Efllux/fw2usb/hardware/README.md

# hardware

KiCad designs, licensed CERN-OHL-S v2 (strongly reciprocal) (see `LICENSE` in this folder).

- `phy-breakout/`: PHY breakout for FPGA dev boards (TSB41BA3F-EP, one FW400 port). Routed and
  checked, not yet built. See its README.
- Planned: the final dongle. See ROADMAP M1 and M5.
