Efllux/fw2usb/host/README.md

# host

Rust user-space tools for the computer side (libusb, no kernel driver): `fw2usb-cli` for bus
info, config ROM dumps and WAV recording via the raw-link mode. Not started; see ROADMAP M3.
