Efllux/fw2usb/docs/devices/tascam.md

# TASCAM vendor protocol

Research, not fw2usb device support. Primary source snapshots are pinned below.

Stream: CIP-like PCM plus capture counter/status quadlets. Control: Vendor registers, separate async control/MIDI. Linux: `snd-firewire-tascam`.

## Start, clock and recovery

Select formats/rate, reserve resources; program TX channel, unknown register=2, RX channel, start=1, RX on=1, option=0x2000, multiplex PCM enable; add playback at peer speed and capture at S400; start event-count replay domain (16000 initial skips when needed), wait ready. Failure stops domain and finishes session.

Capture includes two non-PCM quadlets; MIDI/status is not a generic AM824 layout. Firmware can delay event multiplexing after rate change; received SYT ignored, packet cadence matters. Unknown register purposes must remain explicit.

Firmware upload: No routine Linux stream-start upload; boot/recovery unknown.

## Tier-1 profile requirements

Match ROM IDs and firmware revisions, include per-rate/per-optical-mode capture
and playback wire layouts, PCM slot map, MIDI/control placement, peak packet
size, bus-speed requirements, clock source/lock operations, packet cadence and
timestamp rules, resource acquisition, bounded startup waits, error teardown
and generation-reset recovery. Encode family-specific quirks above explicitly.
Do not expose unsupported rates or infer channel count from the product name.

## Model evidence

Counts below are capture/playback PCM, excluding MIDI; ? means **[verify]** from
capability queries or captures, not zero channels. Clock behavior, upload needs
and quirks inherit the family discussion; per-model exceptions need verification.
FFADO registration indicates a source match, not fw2usb or current FFADO validation.

| Vendor | Model | ROM vendor/model | PCM at <=48 / 88.2–96 / 176.4–192 kHz | Source |
|---|---|---|---|---|
| TASCAM | FW-1884 | see ROM match table | ? / ? / ? | [match](https://github.com/torvalds/linux/blob/7475ea8b58616b33c04afb976cf0fbaad9dd63fb/sound/firewire/tascam/tascam.c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) |
| TASCAM | FW-1082 | see ROM match table | ? / ? / ? | [match](https://github.com/torvalds/linux/blob/7475ea8b58616b33c04afb976cf0fbaad9dd63fb/sound/firewire/tascam/tascam.c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) |
| TASCAM | FW-1804 | see ROM match table | ? / ? / ? | [match](https://github.com/torvalds/linux/blob/7475ea8b58616b33c04afb976cf0fbaad9dd63fb/sound/firewire/tascam/tascam.c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) |

## Primary implementation references

- [sound/firewire/tascam/tascam-stream.c:1–551](https://github.com/torvalds/linux/blob/7475ea8b58616b33c04afb976cf0fbaad9dd63fb/sound/firewire/tascam/tascam-stream.c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)
- [sound/firewire/tascam/tascam.c:1–235](https://github.com/torvalds/linux/blob/7475ea8b58616b33c04afb976cf0fbaad9dd63fb/sound/firewire/tascam/tascam.c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)
- [sound/firewire/tascam/amdtp-tascam.c:1–252](https://github.com/torvalds/linux/blob/7475ea8b58616b33c04afb976cf0fbaad9dd63fb/sound/firewire/tascam/amdtp-tascam.c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)

### Sequence and layout audit anchors

- [tascam/tascam-stream.c:222–280](https://github.com/torvalds/linux/blob/7475ea8b58616b33c04afb976cf0fbaad9dd63fb/sound/firewire/tascam/tascam-stream.c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)
- [tascam/tascam-stream.c:435–510](https://github.com/torvalds/linux/blob/7475ea8b58616b33c04afb976cf0fbaad9dd63fb/sound/firewire/tascam/tascam-stream.c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)
- [tascam/tascam.c:14–43](https://github.com/torvalds/linux/blob/7475ea8b58616b33c04afb976cf0fbaad9dd63fb/sound/firewire/tascam/tascam.c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)

### Channel derivation

The model table tascam.c:14–43 gives FW1884 analog 8/8, FW1082 8/2,
FW1804 8/2. tascam-stream.c:306–324 adds eight slots for ADAT-equipped
models and two for S/PDIF-equipped models: FW1884 18/18, FW1082 10/4,
FW1804 18/12 wire PCM slots. Capture adds two counter/status quadlets.
These fixed wire slots must not be confused with active optical channel count
at each rate; validate digital-mode operation at 88.2/96 kHz [verify].
