Efllux/fw2usb/hardware/soft-phy-afe/spice/eye.png

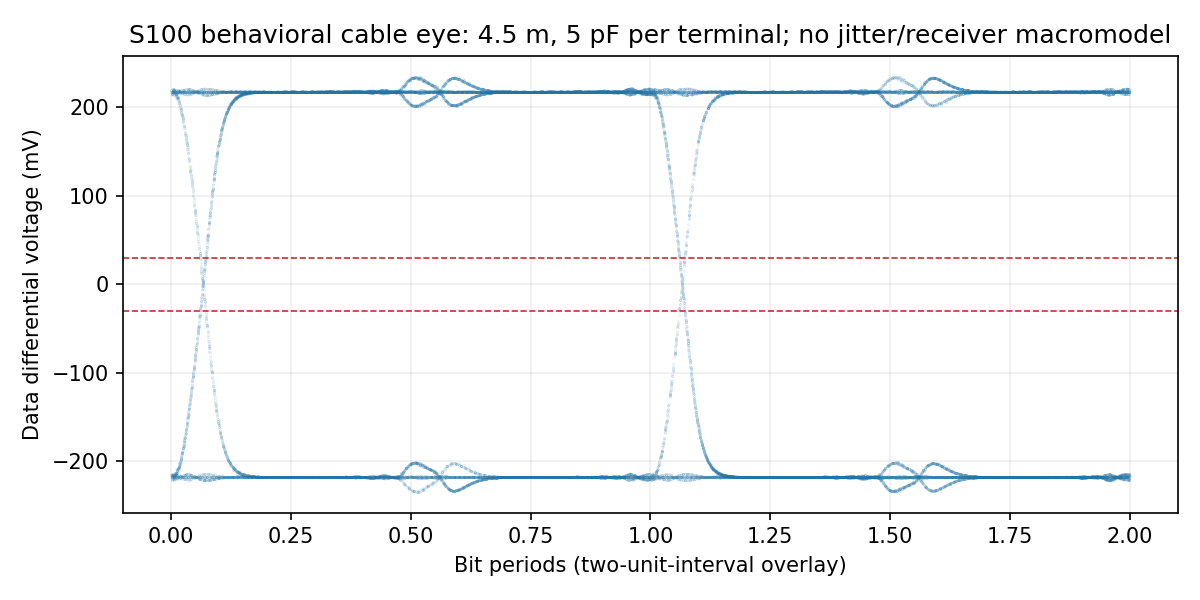
hardware/soft-phy-afe/spice/eye.png
