Efllux/fw2usb/docs/devices/models.csv

vendor | model | family | ids | source | stream_format | control_protocol | firmware_upload | pcm_counts_per_rate | clock_behavior | quirks | linux_driver | ffado_evidence
Mackie | Onyx Firewire | bebob | 0x00000f/0x00010065 | https://github.com/adiknoth/ffado/blob/4b7f9e86e59ce95f5c60d5eb3070bc75a3dfdd3f/libffado/configuration | CIP AM824 | AV/C/FCP extended stream/plug commands, CMP, vendor mixer | Some M-Audio bootloader identities require host firmware loading; others unknown until firmware identity checked. | [verify]; see family page | see family page; model-specific lock behavior [verify] | see family page; firmware revision [verify] | snd-bebob | configuration registration
Mackie | Onyx Firewire | bebob | 0x00000f/0x00010067 | https://github.com/adiknoth/ffado/blob/4b7f9e86e59ce95f5c60d5eb3070bc75a3dfdd3f/libffado/configuration | CIP AM824 | AV/C/FCP extended stream/plug commands, CMP, vendor mixer | Some M-Audio bootloader identities require host firmware loading; others unknown until firmware identity checked. | [verify]; see family page | see family page; model-specific lock behavior [verify] | see family page; firmware revision [verify] | snd-bebob | configuration registration
Tascam | IFFWDM | bebob | 0x0022E/0x10067 | https://github.com/adiknoth/ffado/blob/4b7f9e86e59ce95f5c60d5eb3070bc75a3dfdd3f/libffado/configuration | CIP AM824 | AV/C/FCP extended stream/plug commands, CMP, vendor mixer | Some M-Audio bootloader identities require host firmware loading; others unknown until firmware identity checked. | [verify]; see family page | see family page; model-specific lock behavior [verify] | see family page; firmware revision [verify] | snd-bebob | configuration registration
Loud Technologies Inc. | Onyx 1640i (DICE) | dice | 0x000ff2/0x000006 | https://github.com/adiknoth/ffado/blob/4b7f9e86e59ce95f5c60d5eb3070bc75a3dfdd3f/libffado/configuration | CIP AM824, multiple streams, high-rate dual-wire variants | DICE register sections, owner/notification transactions, vendor extensions | No routine Linux stream-start upload; revision-specific boot/recovery unknown. | [verify]; see family page | see family page; model-specific lock behavior [verify] | see family page; firmware revision [verify] | snd-dice | configuration registration
Loud Technologies Inc. | Onyx Blackbird | dice | 0x000ff2/0x000007 | https://github.com/adiknoth/ffado/blob/4b7f9e86e59ce95f5c60d5eb3070bc75a3dfdd3f/libffado/configuration | CIP AM824, multiple streams, high-rate dual-wire variants | DICE register sections, owner/notification transactions, vendor extensions | No routine Linux stream-start upload; revision-specific boot/recovery unknown. | [verify]; see family page | see family page; model-specific lock behavior [verify] | see family page; firmware revision [verify] | snd-dice | configuration registration
Loud Technologies Inc. | Onyx 1640i (Oxford) | oxfw | 0x000ff2/0x001640 | https://github.com/adiknoth/ffado/blob/4b7f9e86e59ce95f5c60d5eb3070bc75a3dfdd3f/libffado/configuration | CIP AM824, nonblocking/jumbo quirks | AV/C/FCP stream format + CMP; model mixer commands | No routine Linux stream-start upload; other firmware states unknown. | [verify]; see family page | see family page; model-specific lock behavior [verify] | see family page; firmware revision [verify] | snd-oxfw | configuration registration
Loud Technologies Inc. | Onyx-i | oxfw | 0x000ff2/0x081216 | https://github.com/adiknoth/ffado/blob/4b7f9e86e59ce95f5c60d5eb3070bc75a3dfdd3f/libffado/configuration | CIP AM824, nonblocking/jumbo quirks | AV/C/FCP stream format + CMP; model mixer commands | No routine Linux stream-start upload; other firmware states unknown. | [verify]; see family page | see family page; model-specific lock behavior [verify] | see family page; firmware revision [verify] | snd-oxfw | configuration registration
Behringer | X32 | bebob | 0x001564/0x00000006 | https://github.com/adiknoth/ffado/blob/4b7f9e86e59ce95f5c60d5eb3070bc75a3dfdd3f/libffado/configuration | CIP AM824 | AV/C/FCP extended stream/plug commands, CMP, vendor mixer | Some M-Audio bootloader identities require host firmware loading; others unknown until firmware identity checked. | [verify]; see family page | see family page; model-specific lock behavior [verify] | see family page; firmware revision [verify] | snd-bebob | configuration registration
Behringer | UFX-1604 mixer | bebob | 0x001564/0x00001604 | https://github.com/adiknoth/ffado/blob/4b7f9e86e59ce95f5c60d5eb3070bc75a3dfdd3f/libffado/configuration | CIP AM824 | AV/C/FCP extended stream/plug commands, CMP, vendor mixer | Some M-Audio bootloader identities require host firmware loading; others unknown until firmware identity checked. | [verify]; see family page | see family page; model-specific lock behavior [verify] | see family page; firmware revision [verify] | snd-bebob | configuration registration
Apogee Electronics | Rosetta 200 | bebob | 0x0003db/0x00010048 | https://github.com/adiknoth/ffado/blob/4b7f9e86e59ce95f5c60d5eb3070bc75a3dfdd3f/libffado/configuration | CIP AM824 | AV/C/FCP extended stream/plug commands, CMP, vendor mixer | Some M-Audio bootloader identities require host firmware loading; others unknown until firmware identity checked. | [verify]; see family page | see family page; model-specific lock behavior [verify] | see family page; firmware revision [verify] | snd-bebob | configuration registration
BridgeCo | RD Audio1 | bebob | 0x0007f5/0x00010048 | https://github.com/adiknoth/ffado/blob/4b7f9e86e59ce95f5c60d5eb3070bc75a3dfdd3f/libffado/configuration | CIP AM824 | AV/C/FCP extended stream/plug commands, CMP, vendor mixer | Some M-Audio bootloader identities require host firmware loading; others unknown until firmware identity checked. | [verify]; see family page | see family page; model-specific lock behavior [verify] | see family page; firmware revision [verify] | snd-bebob | configuration registration
BridgeCo | Audio 5 | bebob | 0x0007f5/0x00010049 | https://github.com/adiknoth/ffado/blob/4b7f9e86e59ce95f5c60d5eb3070bc75a3dfdd3f/libffado/configuration | CIP AM824 | AV/C/FCP extended stream/plug commands, CMP, vendor mixer | Some M-Audio bootloader identities require host firmware loading; others unknown until firmware identity checked. | [verify]; see family page | see family page; model-specific lock behavior [verify] | see family page; firmware revision [verify] | snd-bebob | configuration registration
PreSonus | FIREBOX | bebob | 0x000a92/0x00010000 | https://github.com/adiknoth/ffado/blob/4b7f9e86e59ce95f5c60d5eb3070bc75a3dfdd3f/libffado/configuration | CIP AM824 | AV/C/FCP extended stream/plug commands, CMP, vendor mixer | Some M-Audio bootloader identities require host firmware loading; others unknown until firmware identity checked. | [verify]; see family page | see family page; model-specific lock behavior [verify] | see family page; firmware revision [verify] | snd-bebob | configuration registration
PreSonus | Inspire1394 | bebob | 0x000a92/0x00010001 | https://github.com/adiknoth/ffado/blob/4b7f9e86e59ce95f5c60d5eb3070bc75a3dfdd3f/libffado/configuration | CIP AM824 | AV/C/FCP extended stream/plug commands, CMP, vendor mixer | Some M-Audio bootloader identities require host firmware loading; others unknown until firmware identity checked. | [verify]; see family page | see family page; model-specific lock behavior [verify] | see family page; firmware revision [verify] | snd-bebob | configuration registration
PreSonus | FirePOD | bebob | 0x000a92/0x00010066 | https://github.com/adiknoth/ffado/blob/4b7f9e86e59ce95f5c60d5eb3070bc75a3dfdd3f/libffado/configuration | CIP AM824 | AV/C/FCP extended stream/plug commands, CMP, vendor mixer | Some M-Audio bootloader identities require host firmware loading; others unknown until firmware identity checked. | [verify]; see family page | see family page; model-specific lock behavior [verify] | see family page; firmware revision [verify] | snd-bebob | configuration registration
Presonus | Firestudio 26x26 | dice | 0x000a92/0x00000008 | https://github.com/adiknoth/ffado/blob/4b7f9e86e59ce95f5c60d5eb3070bc75a3dfdd3f/libffado/configuration | CIP AM824, multiple streams, high-rate dual-wire variants | DICE register sections, owner/notification transactions, vendor extensions | No routine Linux stream-start upload; revision-specific boot/recovery unknown. | [verify]; see family page | see family page; model-specific lock behavior [verify] | see family page; firmware revision [verify] | snd-dice | configuration registration
Presonus | Firestudio Project | dice | 0x000a92/0x0000000b | https://github.com/adiknoth/ffado/blob/4b7f9e86e59ce95f5c60d5eb3070bc75a3dfdd3f/libffado/configuration | CIP AM824, multiple streams, high-rate dual-wire variants | DICE register sections, owner/notification transactions, vendor extensions | No routine Linux stream-start upload; revision-specific boot/recovery unknown. | [verify]; see family page | see family page; model-specific lock behavior [verify] | see family page; firmware revision [verify] | snd-dice | configuration registration
Presonus | Firestudio Tube | dice | 0x000a92/0x0000000c | https://github.com/adiknoth/ffado/blob/4b7f9e86e59ce95f5c60d5eb3070bc75a3dfdd3f/libffado/configuration | CIP AM824, multiple streams, high-rate dual-wire variants | DICE register sections, owner/notification transactions, vendor extensions | No routine Linux stream-start upload; revision-specific boot/recovery unknown. | [verify]; see family page | see family page; model-specific lock behavior [verify] | see family page; firmware revision [verify] | snd-dice | configuration registration
PreSonus | Firestudio Mobile | dice | 0x000a92/0x00000011 | https://github.com/adiknoth/ffado/blob/4b7f9e86e59ce95f5c60d5eb3070bc75a3dfdd3f/libffado/configuration | CIP AM824, multiple streams, high-rate dual-wire variants | DICE register sections, owner/notification transactions, vendor extensions | No routine Linux stream-start upload; revision-specific boot/recovery unknown. | [verify]; see family page | see family page; model-specific lock behavior [verify] | see family page; firmware revision [verify] | snd-dice | configuration registration
PreSonus | STUDIOLIVE_2442 | dice | 0x00000A92/0x00000012 | https://github.com/adiknoth/ffado/blob/4b7f9e86e59ce95f5c60d5eb3070bc75a3dfdd3f/libffado/configuration | CIP AM824, multiple streams, high-rate dual-wire variants | DICE register sections, owner/notification transactions, vendor extensions | No routine Linux stream-start upload; revision-specific boot/recovery unknown. | [verify]; see family page | see family page; model-specific lock behavior [verify] | see family page; firmware revision [verify] | snd-dice | configuration registration
PreSonus | STUDIOLIVE_1602 | dice | 0x00000A92/0x00000013 | https://github.com/adiknoth/ffado/blob/4b7f9e86e59ce95f5c60d5eb3070bc75a3dfdd3f/libffado/configuration | CIP AM824, multiple streams, high-rate dual-wire variants | DICE register sections, owner/notification transactions, vendor extensions | No routine Linux stream-start upload; revision-specific boot/recovery unknown. | [verify]; see family page | see family page; model-specific lock behavior [verify] | see family page; firmware revision [verify] | snd-dice | configuration registration
PreSonus | STUDIOLIVE_3242_mk2 | dice | 0x00000a92/0x00000014 | https://github.com/adiknoth/ffado/blob/4b7f9e86e59ce95f5c60d5eb3070bc75a3dfdd3f/libffado/configuration | CIP AM824, multiple streams, high-rate dual-wire variants | DICE register sections, owner/notification transactions, vendor extensions | No routine Linux stream-start upload; revision-specific boot/recovery unknown. | [verify]; see family page | see family page; model-specific lock behavior [verify] | see family page; firmware revision [verify] | snd-dice | configuration registration
TerraTec Electronic GmbH | Phase 88 FW | bebob | 0x000aac/0x00000003 | https://github.com/adiknoth/ffado/blob/4b7f9e86e59ce95f5c60d5eb3070bc75a3dfdd3f/libffado/configuration | CIP AM824 | AV/C/FCP extended stream/plug commands, CMP, vendor mixer | Some M-Audio bootloader identities require host firmware loading; others unknown until firmware identity checked. | [verify]; see family page | see family page; model-specific lock behavior [verify] | see family page; firmware revision [verify] | snd-bebob | configuration registration
TerraTec Electronic GmbH | Phase X24 FW (model version 4) | bebob | 0x000aac/0x00000004 | https://github.com/adiknoth/ffado/blob/4b7f9e86e59ce95f5c60d5eb3070bc75a3dfdd3f/libffado/configuration | CIP AM824 | AV/C/FCP extended stream/plug commands, CMP, vendor mixer | Some M-Audio bootloader identities require host firmware loading; others unknown until firmware identity checked. | [verify]; see family page | see family page; model-specific lock behavior [verify] | see family page; firmware revision [verify] | snd-bebob | configuration registration
TerraTec Electronic GmbH | Phase X24 FW (model version 7) | bebob | 0x000aac/0x00000007 | https://github.com/adiknoth/ffado/blob/4b7f9e86e59ce95f5c60d5eb3070bc75a3dfdd3f/libffado/configuration | CIP AM824 | AV/C/FCP extended stream/plug commands, CMP, vendor mixer | Some M-Audio bootloader identities require host firmware loading; others unknown until firmware identity checked. | [verify]; see family page | see family page; model-specific lock behavior [verify] | see family page; firmware revision [verify] | snd-bebob | configuration registration
ESI | Quatafire 610 | bebob | 0x000f1b/0x00010064 | https://github.com/adiknoth/ffado/blob/4b7f9e86e59ce95f5c60d5eb3070bc75a3dfdd3f/libffado/configuration | CIP AM824 | AV/C/FCP extended stream/plug commands, CMP, vendor mixer | Some M-Audio bootloader identities require host firmware loading; others unknown until firmware identity checked. | [verify]; see family page | see family page; model-specific lock behavior [verify] | see family page; firmware revision [verify] | snd-bebob | configuration registration
Focusrite | Saffire Pro26IO | bebob | 0x00130e/0x00000003 | https://github.com/adiknoth/ffado/blob/4b7f9e86e59ce95f5c60d5eb3070bc75a3dfdd3f/libffado/configuration | CIP AM824 | AV/C/FCP extended stream/plug commands, CMP, vendor mixer | Some M-Audio bootloader identities require host firmware loading; others unknown until firmware identity checked. | [verify]; see family page | see family page; model-specific lock behavior [verify] | see family page; firmware revision [verify] | snd-bebob | configuration registration
Focusrite | Saffire Pro10IO | bebob | 0x00130e/0x00000006 | https://github.com/adiknoth/ffado/blob/4b7f9e86e59ce95f5c60d5eb3070bc75a3dfdd3f/libffado/configuration | CIP AM824 | AV/C/FCP extended stream/plug commands, CMP, vendor mixer | Some M-Audio bootloader identities require host firmware loading; others unknown until firmware identity checked. | [verify]; see family page | see family page; model-specific lock behavior [verify] | see family page; firmware revision [verify] | snd-bebob | configuration registration
Focusrite | Saffire (LE) | bebob | 0x00130e/0x00000000 | https://github.com/adiknoth/ffado/blob/4b7f9e86e59ce95f5c60d5eb3070bc75a3dfdd3f/libffado/configuration | CIP AM824 | AV/C/FCP extended stream/plug commands, CMP, vendor mixer | Some M-Audio bootloader identities require host firmware loading; others unknown until firmware identity checked. | [verify]; see family page | see family page; model-specific lock behavior [verify] | see family page; firmware revision [verify] | snd-bebob | configuration registration
EDIROL | FA-66 | bebob | 0x0040ab/0x00010049 | https://github.com/adiknoth/ffado/blob/4b7f9e86e59ce95f5c60d5eb3070bc75a3dfdd3f/libffado/configuration | CIP AM824 | AV/C/FCP extended stream/plug commands, CMP, vendor mixer | Some M-Audio bootloader identities require host firmware loading; others unknown until firmware identity checked. | [verify]; see family page | see family page; model-specific lock behavior [verify] | see family page; firmware revision [verify] | snd-bebob | configuration registration
EDIROL | FA-101 | bebob | 0x0040ab/0x00010048 | https://github.com/adiknoth/ffado/blob/4b7f9e86e59ce95f5c60d5eb3070bc75a3dfdd3f/libffado/configuration | CIP AM824 | AV/C/FCP extended stream/plug commands, CMP, vendor mixer | Some M-Audio bootloader identities require host firmware loading; others unknown until firmware identity checked. | [verify]; see family page | see family page; model-specific lock behavior [verify] | see family page; firmware revision [verify] | snd-bebob | configuration registration
M-Audio | Ozonic | bebob | 0x000d6c/0x0000000a | https://github.com/adiknoth/ffado/blob/4b7f9e86e59ce95f5c60d5eb3070bc75a3dfdd3f/libffado/configuration | CIP AM824 | AV/C/FCP extended stream/plug commands, CMP, vendor mixer | Some M-Audio bootloader identities require host firmware loading; others unknown until firmware identity checked. | [verify]; see family page | see family page; model-specific lock behavior [verify] | see family page; firmware revision [verify] | snd-bebob | configuration registration
M-Audio | FW Solo | bebob | 0x000d6c/0x00010062 | https://github.com/adiknoth/ffado/blob/4b7f9e86e59ce95f5c60d5eb3070bc75a3dfdd3f/libffado/configuration | CIP AM824 | AV/C/FCP extended stream/plug commands, CMP, vendor mixer | Some M-Audio bootloader identities require host firmware loading; others unknown until firmware identity checked. | [verify]; see family page | see family page; model-specific lock behavior [verify] | see family page; firmware revision [verify] | snd-bebob | configuration registration
M-Audio | NRV10 | bebob | 0x000d6c/0x00010081 | https://github.com/adiknoth/ffado/blob/4b7f9e86e59ce95f5c60d5eb3070bc75a3dfdd3f/libffado/configuration | CIP AM824 | AV/C/FCP extended stream/plug commands, CMP, vendor mixer | Some M-Audio bootloader identities require host firmware loading; others unknown until firmware identity checked. | [verify]; see family page | see family page; model-specific lock behavior [verify] | see family page; firmware revision [verify] | snd-bebob | configuration registration
M-Audio | FW Audiophile | bebob | 0x000d6c/0x00010060 | https://github.com/adiknoth/ffado/blob/4b7f9e86e59ce95f5c60d5eb3070bc75a3dfdd3f/libffado/configuration | CIP AM824 | AV/C/FCP extended stream/plug commands, CMP, vendor mixer | Some M-Audio bootloader identities require host firmware loading; others unknown until firmware identity checked. | [verify]; see family page | see family page; model-specific lock behavior [verify] | see family page; firmware revision [verify] | snd-bebob | configuration registration
M-Audio | FW 410 | bebob | 0x000d6c/0x00010046 | https://github.com/adiknoth/ffado/blob/4b7f9e86e59ce95f5c60d5eb3070bc75a3dfdd3f/libffado/configuration | CIP AM824 | AV/C/FCP extended stream/plug commands, CMP, vendor mixer | Some M-Audio bootloader identities require host firmware loading; others unknown until firmware identity checked. | [verify]; see family page | see family page; model-specific lock behavior [verify] | see family page; firmware revision [verify] | snd-bebob | configuration registration
M-Audio | FW 1814 | bebob | 0x000d6c/0x00010071 | https://github.com/adiknoth/ffado/blob/4b7f9e86e59ce95f5c60d5eb3070bc75a3dfdd3f/libffado/configuration | CIP AM824 | AV/C/FCP extended stream/plug commands, CMP, vendor mixer | Some M-Audio bootloader identities require host firmware loading; others unknown until firmware identity checked. | [verify]; see family page | see family page; model-specific lock behavior [verify] | see family page; firmware revision [verify] | snd-bebob | configuration registration
M-Audio | ProjectMix I/O | bebob | 0x000d6c/0x00010091 | https://github.com/adiknoth/ffado/blob/4b7f9e86e59ce95f5c60d5eb3070bc75a3dfdd3f/libffado/configuration | CIP AM824 | AV/C/FCP extended stream/plug commands, CMP, vendor mixer | Some M-Audio bootloader identities require host firmware loading; others unknown until firmware identity checked. | [verify]; see family page | see family page; model-specific lock behavior [verify] | see family page; firmware revision [verify] | snd-bebob | configuration registration
M-Audio | ProFire Lightbridge | bebob | 0x000d6c/0x000100A1 | https://github.com/adiknoth/ffado/blob/4b7f9e86e59ce95f5c60d5eb3070bc75a3dfdd3f/libffado/configuration | CIP AM824 | AV/C/FCP extended stream/plug commands, CMP, vendor mixer | Some M-Audio bootloader identities require host firmware loading; others unknown until firmware identity checked. | [verify]; see family page | see family page; model-specific lock behavior [verify] | see family page; firmware revision [verify] | snd-bebob | configuration registration
M-Audio | ProFire 2626 | dice | 0x000d6c/0x00000010 | https://github.com/adiknoth/ffado/blob/4b7f9e86e59ce95f5c60d5eb3070bc75a3dfdd3f/libffado/configuration | CIP AM824, multiple streams, high-rate dual-wire variants | DICE register sections, owner/notification transactions, vendor extensions | No routine Linux stream-start upload; revision-specific boot/recovery unknown. | [verify]; see family page | see family page; model-specific lock behavior [verify] | see family page; firmware revision [verify] | snd-dice | configuration registration
M-Audio | ProFire 610 | dice | 0x000d6c/0x00000011 | https://github.com/adiknoth/ffado/blob/4b7f9e86e59ce95f5c60d5eb3070bc75a3dfdd3f/libffado/configuration | CIP AM824, multiple streams, high-rate dual-wire variants | DICE register sections, owner/notification transactions, vendor extensions | No routine Linux stream-start upload; revision-specific boot/recovery unknown. | [verify]; see family page | see family page; model-specific lock behavior [verify] | see family page; firmware revision [verify] | snd-dice | configuration registration
Acoustic Reality | eAR Master One | bebob | 0x000aac/0x00000002 | https://github.com/adiknoth/ffado/blob/4b7f9e86e59ce95f5c60d5eb3070bc75a3dfdd3f/libffado/configuration | CIP AM824 | AV/C/FCP extended stream/plug commands, CMP, vendor mixer | Some M-Audio bootloader identities require host firmware loading; others unknown until firmware identity checked. | [verify]; see family page | see family page; model-specific lock behavior [verify] | see family page; firmware revision [verify] | snd-bebob | configuration registration
CME | Matrix K FW | bebob | 0x0000000A/0x00030000 | https://github.com/adiknoth/ffado/blob/4b7f9e86e59ce95f5c60d5eb3070bc75a3dfdd3f/libffado/configuration | CIP AM824 | AV/C/FCP extended stream/plug commands, CMP, vendor mixer | Some M-Audio bootloader identities require host firmware loading; others unknown until firmware identity checked. | [verify]; see family page | see family page; model-specific lock behavior [verify] | see family page; firmware revision [verify] | snd-bebob | configuration registration
Echo | AudioFire2 | fireworks | 0x1486/0xAF2 | https://github.com/adiknoth/ffado/blob/4b7f9e86e59ce95f5c60d5eb3070bc75a3dfdd3f/libffado/configuration | CIP AM824 with EFW DBC/SYT quirks | EFW command/response over async transactions, CMP | Flash firmware state/version queried; no routine stream-start upload. | [verify]; see family page | see family page; model-specific lock behavior [verify] | see family page; firmware revision [verify] | snd-fireworks | configuration registration
Echo | AudioFire4 | fireworks | 0x1486/0xAF4 | https://github.com/adiknoth/ffado/blob/4b7f9e86e59ce95f5c60d5eb3070bc75a3dfdd3f/libffado/configuration | CIP AM824 with EFW DBC/SYT quirks | EFW command/response over async transactions, CMP | Flash firmware state/version queried; no routine stream-start upload. | [verify]; see family page | see family page; model-specific lock behavior [verify] | see family page; firmware revision [verify] | snd-fireworks | configuration registration
Echo | AudioFire8 | fireworks | 0x1486/0xAF8 | https://github.com/adiknoth/ffado/blob/4b7f9e86e59ce95f5c60d5eb3070bc75a3dfdd3f/libffado/configuration | CIP AM824 with EFW DBC/SYT quirks | EFW command/response over async transactions, CMP | Flash firmware state/version queried; no routine stream-start upload. | [verify]; see family page | see family page; model-specific lock behavior [verify] | see family page; firmware revision [verify] | snd-fireworks | configuration registration
Echo | AudioFire8a | fireworks | 0x1486/0xAF9 | https://github.com/adiknoth/ffado/blob/4b7f9e86e59ce95f5c60d5eb3070bc75a3dfdd3f/libffado/configuration | CIP AM824 with EFW DBC/SYT quirks | EFW command/response over async transactions, CMP | Flash firmware state/version queried; no routine stream-start upload. | [verify]; see family page | see family page; model-specific lock behavior [verify] | see family page; firmware revision [verify] | snd-fireworks | configuration registration
Echo | AudioFire12 | fireworks | 0x1486/0xAF12 | https://github.com/adiknoth/ffado/blob/4b7f9e86e59ce95f5c60d5eb3070bc75a3dfdd3f/libffado/configuration | CIP AM824 with EFW DBC/SYT quirks | EFW command/response over async transactions, CMP | Flash firmware state/version queried; no routine stream-start upload. | [verify]; see family page | see family page; model-specific lock behavior [verify] | see family page; firmware revision [verify] | snd-fireworks | configuration registration
Echo | AudioFire12HD | fireworks | 0x1486/0xAF12D | https://github.com/adiknoth/ffado/blob/4b7f9e86e59ce95f5c60d5eb3070bc75a3dfdd3f/libffado/configuration | CIP AM824 with EFW DBC/SYT quirks | EFW command/response over async transactions, CMP | Flash firmware state/version queried; no routine stream-start upload. | [verify]; see family page | see family page; model-specific lock behavior [verify] | see family page; firmware revision [verify] | snd-fireworks | configuration registration
Echo | Fireworks 8 | fireworks | 0x1486/0xF8 | https://github.com/adiknoth/ffado/blob/4b7f9e86e59ce95f5c60d5eb3070bc75a3dfdd3f/libffado/configuration | CIP AM824 with EFW DBC/SYT quirks | EFW command/response over async transactions, CMP | Flash firmware state/version queried; no routine stream-start upload. | [verify]; see family page | see family page; model-specific lock behavior [verify] | see family page; firmware revision [verify] | snd-fireworks | configuration registration
Echo | FW HDMI | fireworks | 0x1486/0xAFD1 | https://github.com/adiknoth/ffado/blob/4b7f9e86e59ce95f5c60d5eb3070bc75a3dfdd3f/libffado/configuration | CIP AM824 with EFW DBC/SYT quirks | EFW command/response over async transactions, CMP | Flash firmware state/version queried; no routine stream-start upload. | [verify]; see family page | see family page; model-specific lock behavior [verify] | see family page; firmware revision [verify] | snd-fireworks | configuration registration
Mackie | Onyx 400F | fireworks | 0xFF2/0x400F | https://github.com/adiknoth/ffado/blob/4b7f9e86e59ce95f5c60d5eb3070bc75a3dfdd3f/libffado/configuration | CIP AM824 with EFW DBC/SYT quirks | EFW command/response over async transactions, CMP | Flash firmware state/version queried; no routine stream-start upload. | [verify]; see family page | see family page; model-specific lock behavior [verify] | see family page; firmware revision [verify] | snd-fireworks | configuration registration
Mackie | Onyx 1200F | fireworks | 0xFF2/0x1200F | https://github.com/adiknoth/ffado/blob/4b7f9e86e59ce95f5c60d5eb3070bc75a3dfdd3f/libffado/configuration | CIP AM824 with EFW DBC/SYT quirks | EFW command/response over async transactions, CMP | Flash firmware state/version queried; no routine stream-start upload. | [verify]; see family page | see family page; model-specific lock behavior [verify] | see family page; firmware revision [verify] | snd-fireworks | configuration registration
Behringer | FCA202 | oxfw | 0x1564/0xFC22 | https://github.com/adiknoth/ffado/blob/4b7f9e86e59ce95f5c60d5eb3070bc75a3dfdd3f/libffado/configuration | CIP AM824, nonblocking/jumbo quirks | AV/C/FCP stream format + CMP; model mixer commands | No routine Linux stream-start upload; other firmware states unknown. | [verify]; see family page | see family page; model-specific lock behavior [verify] | see family page; firmware revision [verify] | snd-oxfw | configuration registration
Stanton DJ | SCS.1m | avc | 0x00001260/0x00001000 | https://github.com/adiknoth/ffado/blob/4b7f9e86e59ce95f5c60d5eb3070bc75a3dfdd3f/libffado/configuration | Discover IEC 61883 format; AM824 only if advertised | AV/C/FCP, plug discovery, CMP | Unknown; do not infer from AV/C compliance. | [verify]; see family page | see family page; model-specific lock behavior [verify] | see family page; firmware revision [verify] | no single universal ALSA driver | configuration registration
Motu | All pre-mark3 devices | motu | 0x0001f2/0x00000000 | https://github.com/adiknoth/ffado/blob/4b7f9e86e59ce95f5c60d5eb3070bc75a3dfdd3f/libffado/configuration | CIP with SPH and packed 3-byte chunks; not AM824 | Vendor registers, register-DSP or command-DSP messages | No routine stream-start upload; revision-specific boot states unknown. | [verify]; see family page | see family page; model-specific lock behavior [verify] | see family page; firmware revision [verify] | snd-motu | configuration registration
Motu | All mark3 devices | motu | 0x0001f2/0x00000001 | https://github.com/adiknoth/ffado/blob/4b7f9e86e59ce95f5c60d5eb3070bc75a3dfdd3f/libffado/configuration | CIP with SPH and packed 3-byte chunks; not AM824 | Vendor registers, register-DSP or command-DSP messages | No routine stream-start upload; revision-specific boot states unknown. | [verify]; see family page | see family page; model-specific lock behavior [verify] | see family page; firmware revision [verify] | snd-motu | configuration registration
RME | FireFace800 | fireface | 0x000a35/0x0001 | https://github.com/adiknoth/ffado/blob/4b7f9e86e59ce95f5c60d5eb3070bc75a3dfdd3f/libffado/configuration | No CIP; proprietary little-endian PCM/event blocks | Vendor async registers + async MIDI/status | No routine stream-start upload; flash recovery unknown. | [verify]; see family page | see family page; model-specific lock behavior [verify] | see family page; firmware revision [verify] | snd-ff | configuration registration
RME | FireFace400 | fireface | 0x000a35/0x0002 | https://github.com/adiknoth/ffado/blob/4b7f9e86e59ce95f5c60d5eb3070bc75a3dfdd3f/libffado/configuration | No CIP; proprietary little-endian PCM/event blocks | Vendor async registers + async MIDI/status | No routine stream-start upload; flash recovery unknown. | [verify]; see family page | see family page; model-specific lock behavior [verify] | see family page; firmware revision [verify] | snd-ff | configuration registration
RME | FireFace UFX | fireface | 0x000a35/0x0003 | https://github.com/adiknoth/ffado/blob/4b7f9e86e59ce95f5c60d5eb3070bc75a3dfdd3f/libffado/configuration | No CIP; proprietary little-endian PCM/event blocks | Vendor async registers + async MIDI/status | No routine stream-start upload; flash recovery unknown. | [verify]; see family page | see family page; model-specific lock behavior [verify] | see family page; firmware revision [verify] | snd-ff | configuration registration
RME | FireFace UCX | fireface | 0x000a35/0x0004 | https://github.com/adiknoth/ffado/blob/4b7f9e86e59ce95f5c60d5eb3070bc75a3dfdd3f/libffado/configuration | No CIP; proprietary little-endian PCM/event blocks | Vendor async registers + async MIDI/status | No routine stream-start upload; flash recovery unknown. | [verify]; see family page | see family page; model-specific lock behavior [verify] | see family page; firmware revision [verify] | snd-ff | configuration registration
RME | FireFace 802 | fireface | 0x000a35/0x0005 | https://github.com/adiknoth/ffado/blob/4b7f9e86e59ce95f5c60d5eb3070bc75a3dfdd3f/libffado/configuration | No CIP; proprietary little-endian PCM/event blocks | Vendor async registers + async MIDI/status | No routine stream-start upload; flash recovery unknown. | [verify]; see family page | see family page; model-specific lock behavior [verify] | see family page; firmware revision [verify] | snd-ff | configuration registration
TCAT | DiceII EVM (1) | dice | 0x000166/0x0001 | https://github.com/adiknoth/ffado/blob/4b7f9e86e59ce95f5c60d5eb3070bc75a3dfdd3f/libffado/configuration | CIP AM824, multiple streams, high-rate dual-wire variants | DICE register sections, owner/notification transactions, vendor extensions | No routine Linux stream-start upload; revision-specific boot/recovery unknown. | [verify]; see family page | see family page; model-specific lock behavior [verify] | see family page; firmware revision [verify] | snd-dice | configuration registration
TCAT | DiceII EVM (2) | dice | 0x000166/0x0002 | https://github.com/adiknoth/ffado/blob/4b7f9e86e59ce95f5c60d5eb3070bc75a3dfdd3f/libffado/configuration | CIP AM824, multiple streams, high-rate dual-wire variants | DICE register sections, owner/notification transactions, vendor extensions | No routine Linux stream-start upload; revision-specific boot/recovery unknown. | [verify]; see family page | see family page; model-specific lock behavior [verify] | see family page; firmware revision [verify] | snd-dice | configuration registration
TCAT | DiceII EVM (4) | dice | 0x000166/0x0004 | https://github.com/adiknoth/ffado/blob/4b7f9e86e59ce95f5c60d5eb3070bc75a3dfdd3f/libffado/configuration | CIP AM824, multiple streams, high-rate dual-wire variants | DICE register sections, owner/notification transactions, vendor extensions | No routine Linux stream-start upload; revision-specific boot/recovery unknown. | [verify]; see family page | see family page; model-specific lock behavior [verify] | see family page; firmware revision [verify] | snd-dice | configuration registration
TC Electronic | Konnekt 24D | dice | 0x000166/0x00000020 | https://github.com/adiknoth/ffado/blob/4b7f9e86e59ce95f5c60d5eb3070bc75a3dfdd3f/libffado/configuration | CIP AM824, multiple streams, high-rate dual-wire variants | DICE register sections, owner/notification transactions, vendor extensions | No routine Linux stream-start upload; revision-specific boot/recovery unknown. | [verify]; see family page | see family page; model-specific lock behavior [verify] | see family page; firmware revision [verify] | snd-dice | configuration registration
TC Electronic | Konnekt 8 | dice | 0x000166/0x00000021 | https://github.com/adiknoth/ffado/blob/4b7f9e86e59ce95f5c60d5eb3070bc75a3dfdd3f/libffado/configuration | CIP AM824, multiple streams, high-rate dual-wire variants | DICE register sections, owner/notification transactions, vendor extensions | No routine Linux stream-start upload; revision-specific boot/recovery unknown. | [verify]; see family page | see family page; model-specific lock behavior [verify] | see family page; firmware revision [verify] | snd-dice | configuration registration
TC Electronic | Studio Konnekt 48 | dice | 0x000166/0x00000022 | https://github.com/adiknoth/ffado/blob/4b7f9e86e59ce95f5c60d5eb3070bc75a3dfdd3f/libffado/configuration | CIP AM824, multiple streams, high-rate dual-wire variants | DICE register sections, owner/notification transactions, vendor extensions | No routine Linux stream-start upload; revision-specific boot/recovery unknown. | [verify]; see family page | see family page; model-specific lock behavior [verify] | see family page; firmware revision [verify] | snd-dice | configuration registration
TC Electronic | Konnekt Live | dice | 0x000166/0x00000023 | https://github.com/adiknoth/ffado/blob/4b7f9e86e59ce95f5c60d5eb3070bc75a3dfdd3f/libffado/configuration | CIP AM824, multiple streams, high-rate dual-wire variants | DICE register sections, owner/notification transactions, vendor extensions | No routine Linux stream-start upload; revision-specific boot/recovery unknown. | [verify]; see family page | see family page; model-specific lock behavior [verify] | see family page; firmware revision [verify] | snd-dice | configuration registration
TC Electronic | Desktop Konnekt 6 | dice | 0x000166/0x00000024 | https://github.com/adiknoth/ffado/blob/4b7f9e86e59ce95f5c60d5eb3070bc75a3dfdd3f/libffado/configuration | CIP AM824, multiple streams, high-rate dual-wire variants | DICE register sections, owner/notification transactions, vendor extensions | No routine Linux stream-start upload; revision-specific boot/recovery unknown. | [verify]; see family page | see family page; model-specific lock behavior [verify] | see family page; firmware revision [verify] | snd-dice | configuration registration
TC Electronic | ImpactTwin | dice | 0x000166/0x00000027 | https://github.com/adiknoth/ffado/blob/4b7f9e86e59ce95f5c60d5eb3070bc75a3dfdd3f/libffado/configuration | CIP AM824, multiple streams, high-rate dual-wire variants | DICE register sections, owner/notification transactions, vendor extensions | No routine Linux stream-start upload; revision-specific boot/recovery unknown. | [verify]; see family page | see family page; model-specific lock behavior [verify] | see family page; firmware revision [verify] | snd-dice | configuration registration
Alesis | io|14 | dice | 0x000595/0x00000001 | https://github.com/adiknoth/ffado/blob/4b7f9e86e59ce95f5c60d5eb3070bc75a3dfdd3f/libffado/configuration | CIP AM824, multiple streams, high-rate dual-wire variants | DICE register sections, owner/notification transactions, vendor extensions | No routine Linux stream-start upload; revision-specific boot/recovery unknown. | [verify]; see family page | see family page; model-specific lock behavior [verify] | see family page; firmware revision [verify] | snd-dice | configuration registration
Alesis | MultiMix-12 / MultiMix-16 Firewire | dice | 0x000595/0x00000000 | https://github.com/adiknoth/ffado/blob/4b7f9e86e59ce95f5c60d5eb3070bc75a3dfdd3f/libffado/configuration | CIP AM824, multiple streams, high-rate dual-wire variants | DICE register sections, owner/notification transactions, vendor extensions | No routine Linux stream-start upload; revision-specific boot/recovery unknown. | [verify]; see family page | see family page; model-specific lock behavior [verify] | see family page; firmware revision [verify] | snd-dice | configuration registration
PreSonus | STUDIOLIVE_1642 | dice | 0x000a92/0x00000010 | https://github.com/adiknoth/ffado/blob/4b7f9e86e59ce95f5c60d5eb3070bc75a3dfdd3f/libffado/configuration | CIP AM824, multiple streams, high-rate dual-wire variants | DICE register sections, owner/notification transactions, vendor extensions | No routine Linux stream-start upload; revision-specific boot/recovery unknown. | [verify]; see family page | see family page; model-specific lock behavior [verify] | see family page; firmware revision [verify] | snd-dice | configuration registration
Focusrite | Saffire PRO 40 | dice | 0x00130e/0x00000005 | https://github.com/adiknoth/ffado/blob/4b7f9e86e59ce95f5c60d5eb3070bc75a3dfdd3f/libffado/configuration | CIP AM824, multiple streams, high-rate dual-wire variants | DICE register sections, owner/notification transactions, vendor extensions | No routine Linux stream-start upload; revision-specific boot/recovery unknown. | [verify]; see family page | see family page; model-specific lock behavior [verify] | see family page; firmware revision [verify] | snd-dice | configuration registration
Focusrite | Saffire PRO 24 | dice | 0x00130e/0x00000007 | https://github.com/adiknoth/ffado/blob/4b7f9e86e59ce95f5c60d5eb3070bc75a3dfdd3f/libffado/configuration | CIP AM824, multiple streams, high-rate dual-wire variants | DICE register sections, owner/notification transactions, vendor extensions | No routine Linux stream-start upload; revision-specific boot/recovery unknown. | [verify]; see family page | see family page; model-specific lock behavior [verify] | see family page; firmware revision [verify] | snd-dice | configuration registration
Focusrite | Saffire PRO 24 DSP | dice | 0x00130e/0x00000008 | https://github.com/adiknoth/ffado/blob/4b7f9e86e59ce95f5c60d5eb3070bc75a3dfdd3f/libffado/configuration | CIP AM824, multiple streams, high-rate dual-wire variants | DICE register sections, owner/notification transactions, vendor extensions | No routine Linux stream-start upload; revision-specific boot/recovery unknown. | [verify]; see family page | see family page; model-specific lock behavior [verify] | see family page; firmware revision [verify] | snd-dice | configuration registration
Focusrite | Saffire PRO 14 | dice | 0x00130e/0x00000009 | https://github.com/adiknoth/ffado/blob/4b7f9e86e59ce95f5c60d5eb3070bc75a3dfdd3f/libffado/configuration | CIP AM824, multiple streams, high-rate dual-wire variants | DICE register sections, owner/notification transactions, vendor extensions | No routine Linux stream-start upload; revision-specific boot/recovery unknown. | [verify]; see family page | see family page; model-specific lock behavior [verify] | see family page; firmware revision [verify] | snd-dice | configuration registration
Focusrite | Saffire PRO 26 | dice | 0x00130e/0x00000012 | https://github.com/adiknoth/ffado/blob/4b7f9e86e59ce95f5c60d5eb3070bc75a3dfdd3f/libffado/configuration | CIP AM824, multiple streams, high-rate dual-wire variants | DICE register sections, owner/notification transactions, vendor extensions | No routine Linux stream-start upload; revision-specific boot/recovery unknown. | [verify]; see family page | see family page; model-specific lock behavior [verify] | see family page; firmware revision [verify] | snd-dice | configuration registration
Focusrite | Saffire PRO 40-1 | dice | 0x00130e/0x000000DE | https://github.com/adiknoth/ffado/blob/4b7f9e86e59ce95f5c60d5eb3070bc75a3dfdd3f/libffado/configuration | CIP AM824, multiple streams, high-rate dual-wire variants | DICE register sections, owner/notification transactions, vendor extensions | No routine Linux stream-start upload; revision-specific boot/recovery unknown. | [verify]; see family page | see family page; model-specific lock behavior [verify] | see family page; firmware revision [verify] | snd-dice | configuration registration
Focusrite | Saffire PRO 40-1 | dice | 0x00130e/0x00000013 | https://github.com/adiknoth/ffado/blob/4b7f9e86e59ce95f5c60d5eb3070bc75a3dfdd3f/libffado/configuration | CIP AM824, multiple streams, high-rate dual-wire variants | DICE register sections, owner/notification transactions, vendor extensions | No routine Linux stream-start upload; revision-specific boot/recovery unknown. | [verify]; see family page | see family page; model-specific lock behavior [verify] | see family page; firmware revision [verify] | snd-dice | configuration registration
Weiss Engineering Ltd. | ADC 2 | dice | 0x001C6A/0x00000001 | https://github.com/adiknoth/ffado/blob/4b7f9e86e59ce95f5c60d5eb3070bc75a3dfdd3f/libffado/configuration | CIP AM824, multiple streams, high-rate dual-wire variants | DICE register sections, owner/notification transactions, vendor extensions | No routine Linux stream-start upload; revision-specific boot/recovery unknown. | [verify]; see family page | see family page; model-specific lock behavior [verify] | see family page; firmware revision [verify] | snd-dice | configuration registration
Weiss Engineering Ltd. | Vesta | dice | 0x001C6A/0x00000002 | https://github.com/adiknoth/ffado/blob/4b7f9e86e59ce95f5c60d5eb3070bc75a3dfdd3f/libffado/configuration | CIP AM824, multiple streams, high-rate dual-wire variants | DICE register sections, owner/notification transactions, vendor extensions | No routine Linux stream-start upload; revision-specific boot/recovery unknown. | [verify]; see family page | see family page; model-specific lock behavior [verify] | see family page; firmware revision [verify] | snd-dice | configuration registration
Weiss Engineering Ltd. | Minerva | dice | 0x001C6A/0x00000003 | https://github.com/adiknoth/ffado/blob/4b7f9e86e59ce95f5c60d5eb3070bc75a3dfdd3f/libffado/configuration | CIP AM824, multiple streams, high-rate dual-wire variants | DICE register sections, owner/notification transactions, vendor extensions | No routine Linux stream-start upload; revision-specific boot/recovery unknown. | [verify]; see family page | see family page; model-specific lock behavior [verify] | see family page; firmware revision [verify] | snd-dice | configuration registration
Weiss Engineering Ltd. | AFI 1 | dice | 0x001C6A/0x00000004 | https://github.com/adiknoth/ffado/blob/4b7f9e86e59ce95f5c60d5eb3070bc75a3dfdd3f/libffado/configuration | CIP AM824, multiple streams, high-rate dual-wire variants | DICE register sections, owner/notification transactions, vendor extensions | No routine Linux stream-start upload; revision-specific boot/recovery unknown. | [verify]; see family page | see family page; model-specific lock behavior [verify] | see family page; firmware revision [verify] | snd-dice | configuration registration
Weiss Engineering Ltd. | TAG DAC1 | dice | 0x001C6A/0x00000005 | https://github.com/adiknoth/ffado/blob/4b7f9e86e59ce95f5c60d5eb3070bc75a3dfdd3f/libffado/configuration | CIP AM824, multiple streams, high-rate dual-wire variants | DICE register sections, owner/notification transactions, vendor extensions | No routine Linux stream-start upload; revision-specific boot/recovery unknown. | [verify]; see family page | see family page; model-specific lock behavior [verify] | see family page; firmware revision [verify] | snd-dice | configuration registration
Weiss Engineering Ltd. | INT 202 | dice | 0x001C6A/0x00000006 | https://github.com/adiknoth/ffado/blob/4b7f9e86e59ce95f5c60d5eb3070bc75a3dfdd3f/libffado/configuration | CIP AM824, multiple streams, high-rate dual-wire variants | DICE register sections, owner/notification transactions, vendor extensions | No routine Linux stream-start upload; revision-specific boot/recovery unknown. | [verify]; see family page | see family page; model-specific lock behavior [verify] | see family page; firmware revision [verify] | snd-dice | configuration registration
Weiss Engineering Ltd. | DAC 202 | dice | 0x001C6A/0x00000007 | https://github.com/adiknoth/ffado/blob/4b7f9e86e59ce95f5c60d5eb3070bc75a3dfdd3f/libffado/configuration | CIP AM824, multiple streams, high-rate dual-wire variants | DICE register sections, owner/notification transactions, vendor extensions | No routine Linux stream-start upload; revision-specific boot/recovery unknown. | [verify]; see family page | see family page; model-specific lock behavior [verify] | see family page; firmware revision [verify] | snd-dice | configuration registration
FlexRadio_Systems | Flex-5000 | dice | 0x001c2d/0x00000001 | https://github.com/adiknoth/ffado/blob/4b7f9e86e59ce95f5c60d5eb3070bc75a3dfdd3f/libffado/configuration | CIP AM824, multiple streams, high-rate dual-wire variants | DICE register sections, owner/notification transactions, vendor extensions | No routine Linux stream-start upload; revision-specific boot/recovery unknown. | [verify]; see family page | see family page; model-specific lock behavior [verify] | see family page; firmware revision [verify] | snd-dice | configuration registration
Phonic | HB 24U | bebob | 0x001496/0x000000 | https://github.com/adiknoth/ffado/blob/4b7f9e86e59ce95f5c60d5eb3070bc75a3dfdd3f/libffado/configuration | CIP AM824 | AV/C/FCP extended stream/plug commands, CMP, vendor mixer | Some M-Audio bootloader identities require host firmware loading; others unknown until firmware identity checked. | [verify]; see family page | see family page; model-specific lock behavior [verify] | see family page; firmware revision [verify] | snd-bebob | configuration registration
Yamaha | GO44 | bebob | 0x0000A0DE/0x0010000B | https://github.com/adiknoth/ffado/blob/4b7f9e86e59ce95f5c60d5eb3070bc75a3dfdd3f/libffado/configuration | CIP AM824 | AV/C/FCP extended stream/plug commands, CMP, vendor mixer | Some M-Audio bootloader identities require host firmware loading; others unknown until firmware identity checked. | [verify]; see family page | see family page; model-specific lock behavior [verify] | see family page; firmware revision [verify] | snd-bebob | configuration registration
Yamaha | GO46 | bebob | 0x0000A0DE/0x0010000C | https://github.com/adiknoth/ffado/blob/4b7f9e86e59ce95f5c60d5eb3070bc75a3dfdd3f/libffado/configuration | CIP AM824 | AV/C/FCP extended stream/plug commands, CMP, vendor mixer | Some M-Audio bootloader identities require host firmware loading; others unknown until firmware identity checked. | [verify]; see family page | see family page; model-specific lock behavior [verify] | see family page; firmware revision [verify] | snd-bebob | configuration registration
DnR | Axum_FireWire_IO_card_16x16 | dice | 0x00000F64/0x00000003 | https://github.com/adiknoth/ffado/blob/4b7f9e86e59ce95f5c60d5eb3070bc75a3dfdd3f/libffado/configuration | CIP AM824, multiple streams, high-rate dual-wire variants | DICE register sections, owner/notification transactions, vendor extensions | No routine Linux stream-start upload; revision-specific boot/recovery unknown. | [verify]; see family page | see family page; model-specific lock behavior [verify] | see family page; firmware revision [verify] | snd-dice | configuration registration
Lexicon | I-ONIX_FW810S | dice | 0x00000FD7/0x00000001 | https://github.com/adiknoth/ffado/blob/4b7f9e86e59ce95f5c60d5eb3070bc75a3dfdd3f/libffado/configuration | CIP AM824, multiple streams, high-rate dual-wire variants | DICE register sections, owner/notification transactions, vendor extensions | No routine Linux stream-start upload; revision-specific boot/recovery unknown. | [verify]; see family page | see family page; model-specific lock behavior [verify] | see family page; firmware revision [verify] | snd-dice | configuration registration
Digidesign | Mbox 2 Pro | bebob | 0x0000A07E/0x000000A9 | https://github.com/adiknoth/ffado/blob/4b7f9e86e59ce95f5c60d5eb3070bc75a3dfdd3f/libffado/configuration | CIP AM824 | AV/C/FCP extended stream/plug commands, CMP, vendor mixer | Some M-Audio bootloader identities require host firmware loading; others unknown until firmware identity checked. | [verify]; see family page | see family page; model-specific lock behavior [verify] | see family page; firmware revision [verify] | snd-bebob | configuration registration
Avid | Mbox 3 Pro | other | 0x0000A07E/0x00000004 | https://github.com/adiknoth/ffado/blob/4b7f9e86e59ce95f5c60d5eb3070bc75a3dfdd3f/libffado/configuration | [verify] | [verify] | [verify] | [verify]; see family page | see family page; model-specific lock behavior [verify] | see family page; firmware revision [verify] | [verify] | configuration registration
Allen and Heath | Zed R16 | dice | 0x000004C4/0x00000000 | https://github.com/adiknoth/ffado/blob/4b7f9e86e59ce95f5c60d5eb3070bc75a3dfdd3f/libffado/configuration | CIP AM824, multiple streams, high-rate dual-wire variants | DICE register sections, owner/notification transactions, vendor extensions | No routine Linux stream-start upload; revision-specific boot/recovery unknown. | [verify]; see family page | see family page; model-specific lock behavior [verify] | see family page; firmware revision [verify] | snd-dice | configuration registration
Midas | Venice F32 | dice | 0x0010C73F/0x00000001 | https://github.com/adiknoth/ffado/blob/4b7f9e86e59ce95f5c60d5eb3070bc75a3dfdd3f/libffado/configuration | CIP AM824, multiple streams, high-rate dual-wire variants | DICE register sections, owner/notification transactions, vendor extensions | No routine Linux stream-start upload; revision-specific boot/recovery unknown. | [verify]; see family page | see family page; model-specific lock behavior [verify] | see family page; firmware revision [verify] | snd-dice | configuration registration
ICON | FireXon | bebob | 0x00001A9E/0x00000001 | https://github.com/adiknoth/ffado/blob/4b7f9e86e59ce95f5c60d5eb3070bc75a3dfdd3f/libffado/configuration | CIP AM824 | AV/C/FCP extended stream/plug commands, CMP, vendor mixer | Some M-Audio bootloader identities require host firmware loading; others unknown until firmware identity checked. | [verify]; see family page | see family page; model-specific lock behavior [verify] | see family page; firmware revision [verify] | snd-bebob | configuration registration
TASCAM | FW-1884 | tascam | see ROM match table | https://github.com/torvalds/linux/blob/7475ea8b58616b33c04afb976cf0fbaad9dd63fb/sound/firewire/tascam/tascam.c | CIP-like PCM plus capture counter/status quadlets | Vendor registers, separate async control/MIDI | No routine Linux stream-start upload; boot/recovery unknown. | [verify]; see family page | see family page; model-specific lock behavior [verify] | see family page; firmware revision [verify] | snd-firewire-tascam | Linux model addition
TASCAM | FW-1082 | tascam | see ROM match table | https://github.com/torvalds/linux/blob/7475ea8b58616b33c04afb976cf0fbaad9dd63fb/sound/firewire/tascam/tascam.c | CIP-like PCM plus capture counter/status quadlets | Vendor registers, separate async control/MIDI | No routine Linux stream-start upload; boot/recovery unknown. | [verify]; see family page | see family page; model-specific lock behavior [verify] | see family page; firmware revision [verify] | snd-firewire-tascam | Linux model addition
TASCAM | FW-1804 | tascam | see ROM match table | https://github.com/torvalds/linux/blob/7475ea8b58616b33c04afb976cf0fbaad9dd63fb/sound/firewire/tascam/tascam.c | CIP-like PCM plus capture counter/status quadlets | Vendor registers, separate async control/MIDI | No routine Linux stream-start upload; boot/recovery unknown. | [verify]; see family page | see family page; model-specific lock behavior [verify] | see family page; firmware revision [verify] | snd-firewire-tascam | Linux model addition
Digidesign | Digi 002 | digi00x | see ROM match table | https://github.com/torvalds/linux/blob/7475ea8b58616b33c04afb976cf0fbaad9dd63fb/sound/firewire/digi00x/digi00x.c | CIP-like DOT PCM transform + MIDI quadlet | Vendor register/session protocol | No routine Linux stream-start upload; boot/recovery unknown. | [verify]; see family page | see family page; model-specific lock behavior [verify] | see family page; firmware revision [verify] | snd-digi00x | Linux model addition
Digidesign | Digi 002 Rack | digi00x | see ROM match table | https://github.com/torvalds/linux/blob/7475ea8b58616b33c04afb976cf0fbaad9dd63fb/sound/firewire/digi00x/digi00x.c | CIP-like DOT PCM transform + MIDI quadlet | Vendor register/session protocol | No routine Linux stream-start upload; boot/recovery unknown. | [verify]; see family page | see family page; model-specific lock behavior [verify] | see family page; firmware revision [verify] | snd-digi00x | Linux model addition
Digidesign | Digi 003 | digi00x | see ROM match table | https://github.com/torvalds/linux/blob/7475ea8b58616b33c04afb976cf0fbaad9dd63fb/sound/firewire/digi00x/digi00x.c | CIP-like DOT PCM transform + MIDI quadlet | Vendor register/session protocol | No routine Linux stream-start upload; boot/recovery unknown. | [verify]; see family page | see family page; model-specific lock behavior [verify] | see family page; firmware revision [verify] | snd-digi00x | Linux model addition
Digidesign | Digi 003 Rack | digi00x | see ROM match table | https://github.com/torvalds/linux/blob/7475ea8b58616b33c04afb976cf0fbaad9dd63fb/sound/firewire/digi00x/digi00x.c | CIP-like DOT PCM transform + MIDI quadlet | Vendor register/session protocol | No routine Linux stream-start upload; boot/recovery unknown. | [verify]; see family page | see family page; model-specific lock behavior [verify] | see family page; firmware revision [verify] | snd-digi00x | Linux model addition
MOTU | 828 | motu | see ROM match table | https://github.com/torvalds/linux/blob/7475ea8b58616b33c04afb976cf0fbaad9dd63fb/sound/firewire/motu/motu.c | CIP with SPH and packed 3-byte chunks; not AM824 | Vendor registers, register-DSP or command-DSP messages | No routine stream-start upload; revision-specific boot states unknown. | [verify]; see family page | see family page; model-specific lock behavior [verify] | see family page; firmware revision [verify] | snd-motu | Linux model addition
MOTU | 828mkII | motu | see ROM match table | https://github.com/torvalds/linux/blob/7475ea8b58616b33c04afb976cf0fbaad9dd63fb/sound/firewire/motu/motu.c | CIP with SPH and packed 3-byte chunks; not AM824 | Vendor registers, register-DSP or command-DSP messages | No routine stream-start upload; revision-specific boot states unknown. | [verify]; see family page | see family page; model-specific lock behavior [verify] | see family page; firmware revision [verify] | snd-motu | Linux model addition
MOTU | 896 | motu | see ROM match table | https://github.com/torvalds/linux/blob/7475ea8b58616b33c04afb976cf0fbaad9dd63fb/sound/firewire/motu/motu.c | CIP with SPH and packed 3-byte chunks; not AM824 | Vendor registers, register-DSP or command-DSP messages | No routine stream-start upload; revision-specific boot states unknown. | [verify]; see family page | see family page; model-specific lock behavior [verify] | see family page; firmware revision [verify] | snd-motu | Linux model addition
MOTU | 896HD | motu | see ROM match table | https://github.com/torvalds/linux/blob/7475ea8b58616b33c04afb976cf0fbaad9dd63fb/sound/firewire/motu/motu.c | CIP with SPH and packed 3-byte chunks; not AM824 | Vendor registers, register-DSP or command-DSP messages | No routine stream-start upload; revision-specific boot states unknown. | [verify]; see family page | see family page; model-specific lock behavior [verify] | see family page; firmware revision [verify] | snd-motu | Linux model addition
MOTU | Traveler | motu | see ROM match table | https://github.com/torvalds/linux/blob/7475ea8b58616b33c04afb976cf0fbaad9dd63fb/sound/firewire/motu/motu.c | CIP with SPH and packed 3-byte chunks; not AM824 | Vendor registers, register-DSP or command-DSP messages | No routine stream-start upload; revision-specific boot states unknown. | [verify]; see family page | see family page; model-specific lock behavior [verify] | see family page; firmware revision [verify] | snd-motu | Linux model addition
MOTU | UltraLite | motu | see ROM match table | https://github.com/torvalds/linux/blob/7475ea8b58616b33c04afb976cf0fbaad9dd63fb/sound/firewire/motu/motu.c | CIP with SPH and packed 3-byte chunks; not AM824 | Vendor registers, register-DSP or command-DSP messages | No routine stream-start upload; revision-specific boot states unknown. | [verify]; see family page | see family page; model-specific lock behavior [verify] | see family page; firmware revision [verify] | snd-motu | Linux model addition
MOTU | 8pre | motu | see ROM match table | https://github.com/torvalds/linux/blob/7475ea8b58616b33c04afb976cf0fbaad9dd63fb/sound/firewire/motu/motu.c | CIP with SPH and packed 3-byte chunks; not AM824 | Vendor registers, register-DSP or command-DSP messages | No routine stream-start upload; revision-specific boot states unknown. | [verify]; see family page | see family page; model-specific lock behavior [verify] | see family page; firmware revision [verify] | snd-motu | Linux model addition
MOTU | 828mk3 | motu | see ROM match table | https://github.com/torvalds/linux/blob/7475ea8b58616b33c04afb976cf0fbaad9dd63fb/sound/firewire/motu/motu.c | CIP with SPH and packed 3-byte chunks; not AM824 | Vendor registers, register-DSP or command-DSP messages | No routine stream-start upload; revision-specific boot states unknown. | [verify]; see family page | see family page; model-specific lock behavior [verify] | see family page; firmware revision [verify] | snd-motu | Linux model addition
MOTU | 896mk3 | motu | see ROM match table | https://github.com/torvalds/linux/blob/7475ea8b58616b33c04afb976cf0fbaad9dd63fb/sound/firewire/motu/motu.c | CIP with SPH and packed 3-byte chunks; not AM824 | Vendor registers, register-DSP or command-DSP messages | No routine stream-start upload; revision-specific boot states unknown. | [verify]; see family page | see family page; model-specific lock behavior [verify] | see family page; firmware revision [verify] | snd-motu | Linux model addition
MOTU | UltraLite mk3 | motu | see ROM match table | https://github.com/torvalds/linux/blob/7475ea8b58616b33c04afb976cf0fbaad9dd63fb/sound/firewire/motu/motu.c | CIP with SPH and packed 3-byte chunks; not AM824 | Vendor registers, register-DSP or command-DSP messages | No routine stream-start upload; revision-specific boot states unknown. | [verify]; see family page | see family page; model-specific lock behavior [verify] | see family page; firmware revision [verify] | snd-motu | Linux model addition
MOTU | Audio Express | motu | see ROM match table | https://github.com/torvalds/linux/blob/7475ea8b58616b33c04afb976cf0fbaad9dd63fb/sound/firewire/motu/motu.c | CIP with SPH and packed 3-byte chunks; not AM824 | Vendor registers, register-DSP or command-DSP messages | No routine stream-start upload; revision-specific boot states unknown. | [verify]; see family page | see family page; model-specific lock behavior [verify] | see family page; firmware revision [verify] | snd-motu | Linux model addition
MOTU | 4pre | motu | see ROM match table | https://github.com/torvalds/linux/blob/7475ea8b58616b33c04afb976cf0fbaad9dd63fb/sound/firewire/motu/motu.c | CIP with SPH and packed 3-byte chunks; not AM824 | Vendor registers, register-DSP or command-DSP messages | No routine stream-start upload; revision-specific boot states unknown. | [verify]; see family page | see family page; model-specific lock behavior [verify] | see family page; firmware revision [verify] | snd-motu | Linux model addition
MOTU | Track16 | motu | see ROM match table | https://github.com/torvalds/linux/blob/7475ea8b58616b33c04afb976cf0fbaad9dd63fb/sound/firewire/motu/motu.c | CIP with SPH and packed 3-byte chunks; not AM824 | Vendor registers, register-DSP or command-DSP messages | No routine stream-start upload; revision-specific boot states unknown. | [verify]; see family page | see family page; model-specific lock behavior [verify] | see family page; firmware revision [verify] | snd-motu | Linux model addition
RME | Fireface 400 | fireface | see ROM match table | https://github.com/torvalds/linux/blob/7475ea8b58616b33c04afb976cf0fbaad9dd63fb/sound/firewire/fireface/ff.c | No CIP; proprietary little-endian PCM/event blocks | Vendor async registers + async MIDI/status | No routine stream-start upload; flash recovery unknown. | [verify]; see family page | see family page; model-specific lock behavior [verify] | see family page; firmware revision [verify] | snd-ff | Linux model addition
RME | Fireface 800 | fireface | see ROM match table | https://github.com/torvalds/linux/blob/7475ea8b58616b33c04afb976cf0fbaad9dd63fb/sound/firewire/fireface/ff.c | No CIP; proprietary little-endian PCM/event blocks | Vendor async registers + async MIDI/status | No routine stream-start upload; flash recovery unknown. | [verify]; see family page | see family page; model-specific lock behavior [verify] | see family page; firmware revision [verify] | snd-ff | Linux model addition
Griffin | FireWave | oxfw | see ROM match table | https://github.com/torvalds/linux/blob/7475ea8b58616b33c04afb976cf0fbaad9dd63fb/sound/firewire/oxfw/oxfw.c | CIP AM824, nonblocking/jumbo quirks | AV/C/FCP stream format + CMP; model mixer commands | No routine Linux stream-start upload; other firmware states unknown. | [verify]; see family page | see family page; model-specific lock behavior [verify] | see family page; firmware revision [verify] | snd-oxfw | Linux model addition
