Efllux/fw2usb/hardware/soft-phy-afe/spice/ds-results.csv

direction | pattern | bits | bit_errors | XOR_edges_between_centers | minimum_signed_eye_mV | tested_center_timing_window_ns | margin_over_30mV_data_threshold_mV
forward | prbs | 1024 | 0 | 1023 | 202.07122813152645 | 3.76 | 172.07122813152645
forward | zero | 1024 | 0 | 1023 | 217.32394646093843 | 3.76 | 187.32394646093843
forward | one | 1024 | 0 | 1023 | 217.32394646093843 | 3.76 | 187.32394646093843
forward | alternating | 1024 | 0 | 1023 | 217.32394646093843 | 3.76 | 187.32394646093843
reverse | prbs | 1024 | 0 | 1023 | 202.07121813803707 | 3.76 | 172.07121813803707
reverse | zero | 1024 | 0 | 1023 | 217.3239364609385 | 3.76 | 187.3239364609385
reverse | one | 1024 | 0 | 1023 | 217.3239364609385 | 3.76 | 187.3239364609385
reverse | alternating | 1024 | 0 | 1023 | 217.3239364609385 | 3.76 | 187.3239364609385
