Efllux/fw2usb/hardware/phy-breakout/phy-breakout.kicad_pcb

## KiCad design hardware/phy-breakout/phy-breakout.kicad_pcb (2026-11-13)

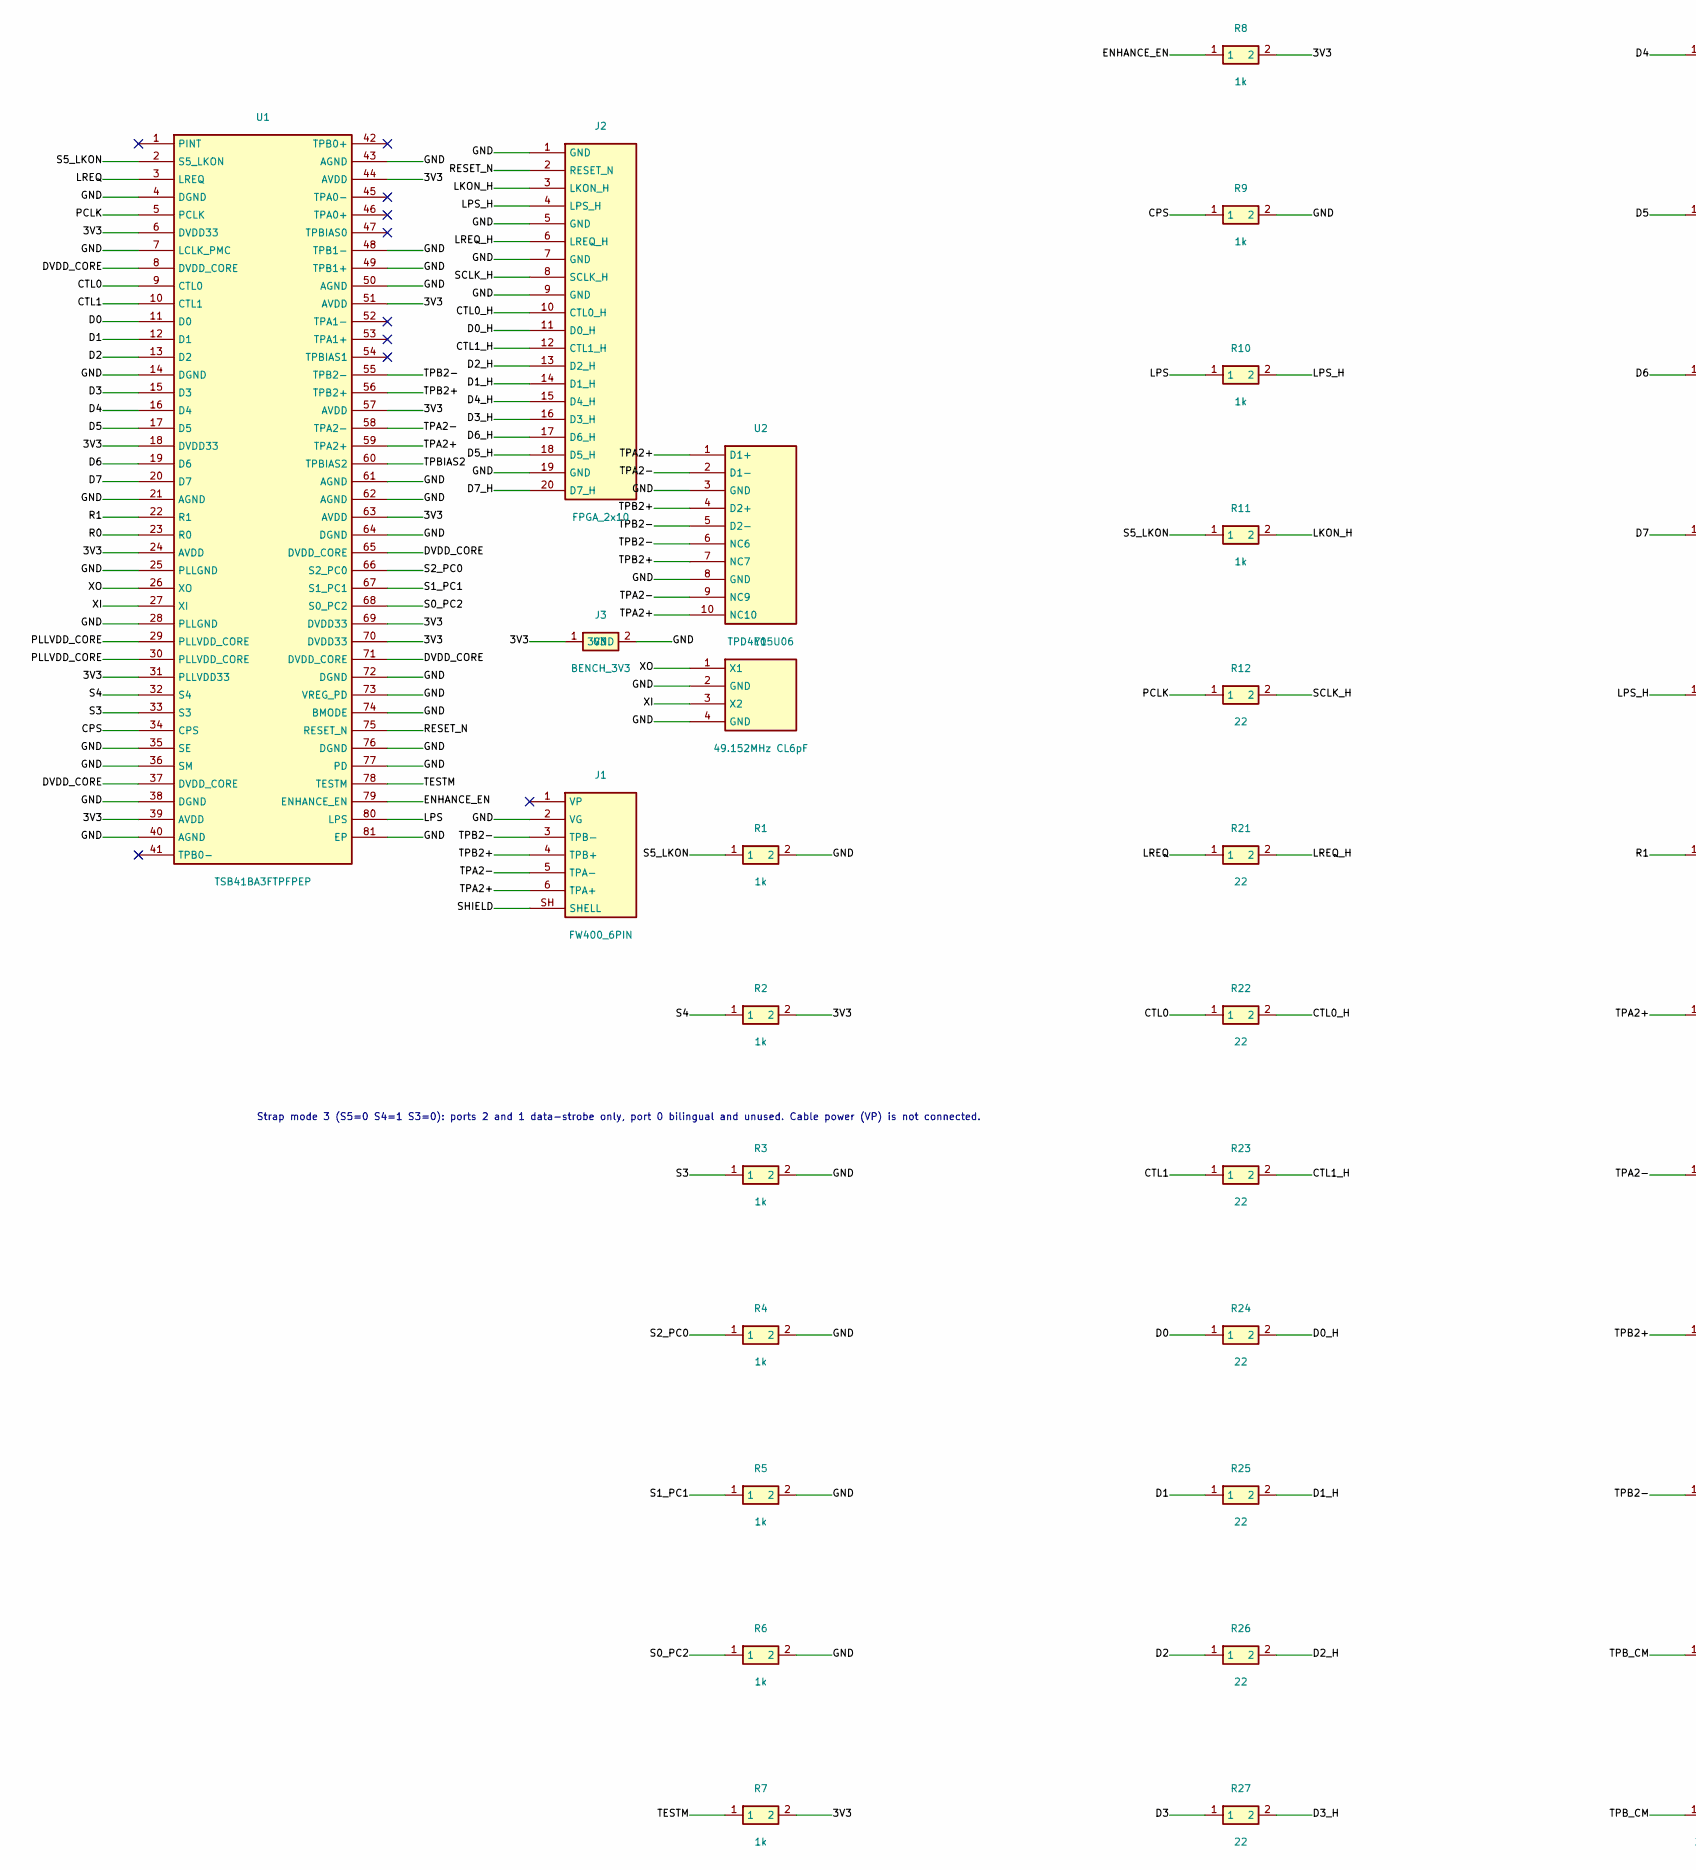
[picture p2: schematic phy-breakout.kicad_sch, fw2usb PHY breakout, part in row 1, column 1]

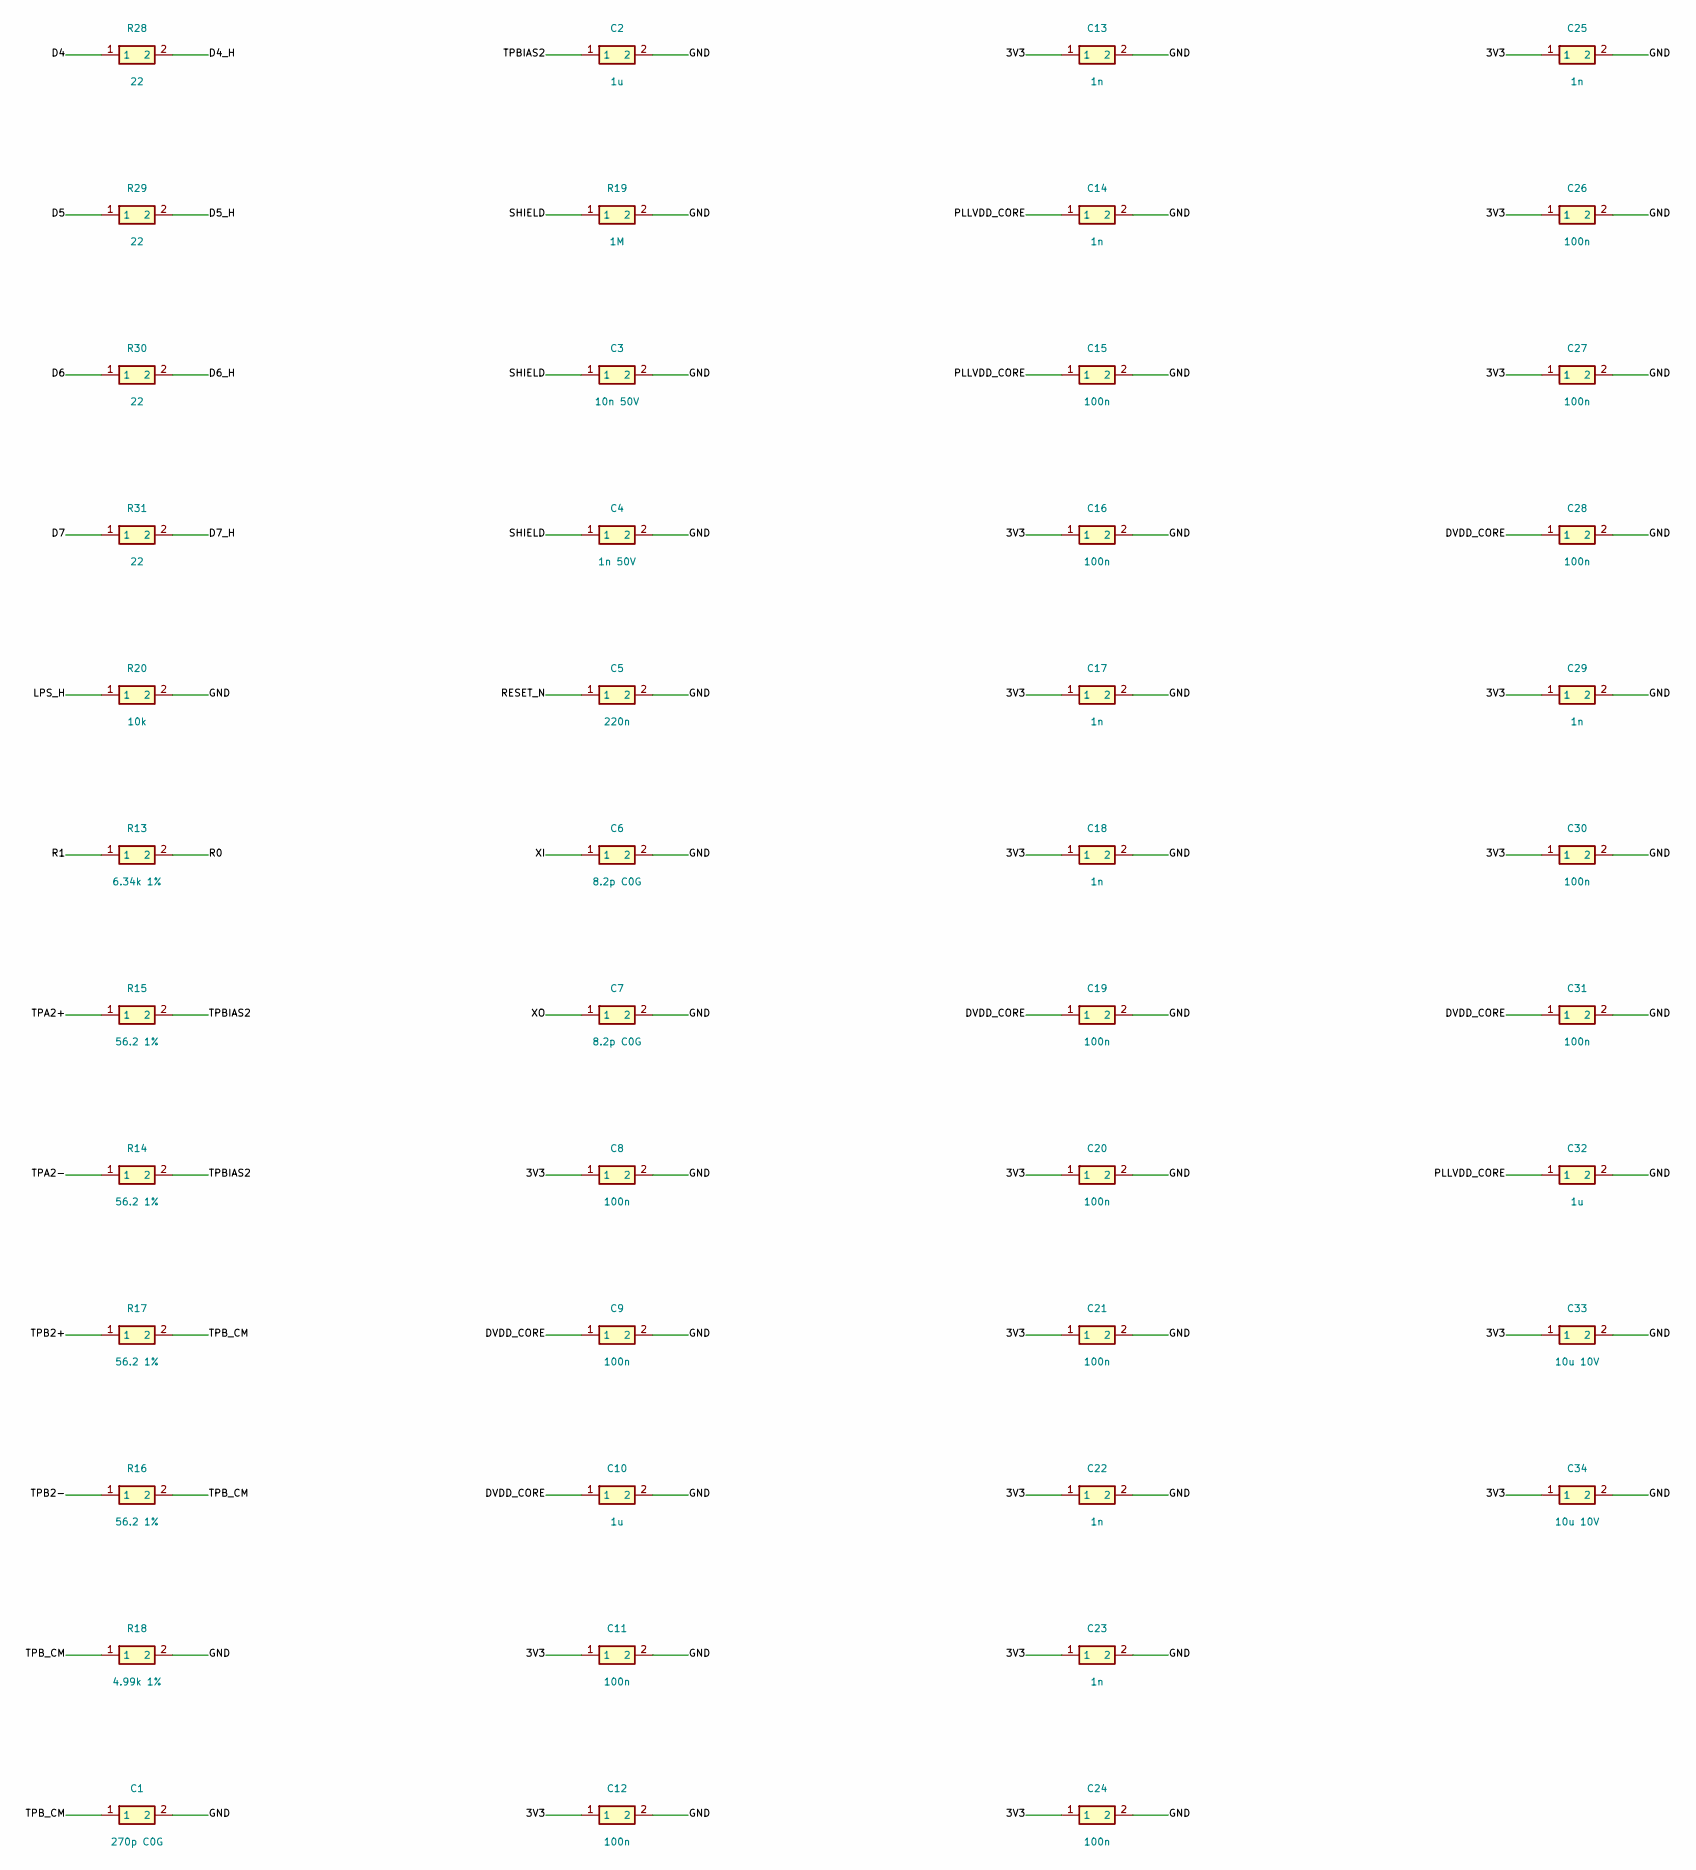
[picture p3: schematic phy-breakout.kicad_sch, fw2usb PHY breakout, part in row 1, column 2]

Parts:
C1: 270p C0G; C; MPN Murata GRM1555C1H271JA01D
C2, C10, C32: 1u; C; MPN Murata GRM155R61A105KE15D
C3: 10n 50V; C0603; MPN Murata GRM188R71H103KA01D
C4: 1n 50V; C0603; MPN Murata GRM1885C1H102JA01D
C5: 220n; C; MPN Murata GRM155R71C224KA12D
C6, C7: 8.2p C0G; C; MPN Murata GRM1555C1H8R2DA01D
C8, C9, C11, C12, C15, C16, C19, C20, C21, C24, C26, C27, C28, C30, C31: 100n; C; MPN Murata GRM155R71C104KA88D
C13, C14, C17, C18, C22, C23, C25, C29: 1n; C; MPN Murata GRM1555C1H102JA01D
C33, C34: 10u 10V; C0805; MPN Murata GRM21BR61A106KE19L
J1: FW400_6PIN; FW6SMT; MPN Keystone 927TR
J2: FPGA_2x10; Header20; MPN Samtec TSW-110-07-G-D
J3: BENCH_3V3; Header2; MPN Samtec TSW-102-07-G-S
R1, R2, R3, R4, R5, R6, R7, R8, R9, R10, R11: 1k; R; MPN Yageo RC0402FR-071KL
R12, R21, R22, R23, R24, R25, R26, R27, R28, R29, R30, R31: 22; R; MPN Yageo RC0402FR-0722RL
R13: 6.34k 1%; R; MPN Yageo RC0402FR-076K34L
R14, R15, R16, R17: 56.2 1%; R; MPN Yageo RC0402FR-0756R2L
R18: 4.99k 1%; R; MPN Yageo RC0402FR-074K99L
R19: 1M; R0603; MPN Yageo RC0603FR-071ML
R20: 10k; R; MPN Yageo RC0402FR-0710KL
U1: TSB41BA3FTPFPEP; HTQFP80; MPN TI TSB41BA3FTPFPEP
U2: TPD4E05U06; USON10; MPN TI TPD4E05U06DQAR
Y1: 49.152MHz CL6pF; Crystal4; MPN Abracon ABM8W-49.1520MHZ-6-K1Z-T3

Connections:
/3V3: C8.1, C11.1, C12.1, C13.1, C16.1, C17.1, C18.1, C20.1, C21.1, C22.1, C23.1, C24.1, C25.1, C26.1, C27.1, C29.1, C30.1, C33.1, C34.1, J3.1 (3V3), R2.2, R7.2, R8.2, U1.6 (DVDD33), U1.18 (DVDD33), U1.24 (AVDD), U1.31 (PLLVDD33), U1.39 (AVDD), U1.44 (AVDD), U1.51 (AVDD), U1.57 (AVDD), U1.63 (AVDD), U1.69 (DVDD33), U1.70 (DVDD33)
/CPS: R9.1, U1.34 (CPS)
/CTL0: R22.1, U1.9 (CTL0)
/CTL0_H: J2.10 (CTL0_H), R22.2
/CTL1: R23.1, U1.10 (CTL1)
/CTL1_H: J2.12 (CTL1_H), R23.2
/D0: R24.1, U1.11 (D0)
/D0_H: J2.11 (D0_H), R24.2
/D1: R25.1, U1.12 (D1)
/D1_H: J2.14 (D1_H), R25.2
/D2: R26.1, U1.13 (D2)
/D2_H: J2.13 (D2_H), R26.2
/D3: R27.1, U1.15 (D3)
/D3_H: J2.16 (D3_H), R27.2
/D4: R28.1, U1.16 (D4)
/D4_H: J2.15 (D4_H), R28.2
/D5: R29.1, U1.17 (D5)
/D5_H: J2.18 (D5_H), R29.2
/D6: R30.1, U1.19 (D6)
/D6_H: J2.17 (D6_H), R30.2
/D7: R31.1, U1.20 (D7)
/D7_H: J2.20 (D7_H), R31.2
/DVDD_CORE: C9.1, C10.1, C19.1, C28.1, C31.1, U1.8 (DVDD_CORE), U1.37 (DVDD_CORE), U1.65 (DVDD_CORE), U1.71 (DVDD_CORE)
/ENHANCE_EN: R8.1, U1.79 (ENHANCE_EN)
/GND: C1.2, C2.2, C3.2, C4.2, C5.2, C6.2, C7.2, C8.2, C9.2, C10.2, C11.2, C12.2, C13.2, C14.2, C15.2, C16.2, C17.2, C18.2, C19.2, C20.2, C21.2, C22.2, C23.2, C24.2, C25.2, C26.2, C27.2, C28.2, C29.2, C30.2, C31.2, C32.2, C33.2, C34.2, J1.2 (VG), J2.1 (GND), J2.5 (GND), J2.7 (GND), J2.9 (GND), J2.19 (GND), J3.2 (GND), R1.2, R3.2, R4.2, R5.2, R6.2, R9.2, R18.2, R19.2, R20.2, U1.4 (DGND), U1.7 (LCLK_PMC), U1.14 (DGND), U1.21 (AGND), U1.25 (PLLGND), U1.28 (PLLGND), U1.35 (SE), U1.36 (SM), U1.38 (DGND), U1.40 (AGND), U1.43 (AGND), U1.48 (TPB1-), U1.49 (TPB1+), U1.50 (AGND), U1.61 (AGND), U1.62 (AGND), U1.64 (DGND), U1.72 (DGND), U1.73 (VREG_PD), U1.74 (BMODE), U1.76 (DGND), U1.77 (PD), U1.81 (EP), U2.3 (GND), U2.8 (GND), Y1.2 (GND), Y1.4 (GND)
/LKON_H: J2.3 (LKON_H), R11.2
/LPS: R10.1, U1.80 (LPS)
/LPS_H: J2.4 (LPS_H), R10.2, R20.1
/LREQ: R21.1, U1.3 (LREQ)
/LREQ_H: J2.6 (LREQ_H), R21.2
/PCLK: R12.1, U1.5 (PCLK)
/PLLVDD_CORE: C14.1, C15.1, C32.1, U1.29 (PLLVDD_CORE), U1.30 (PLLVDD_CORE)
/R0: R13.2, U1.23 (R0)
/R1: R13.1, U1.22 (R1)
/RESET_N: C5.1, J2.2 (RESET_N), U1.75 (RESET_N)
/S0_PC2: R6.1, U1.68 (S0_PC2)
/S1_PC1: R5.1, U1.67 (S1_PC1)
/S2_PC0: R4.1, U1.66 (S2_PC0)
/S3: R3.1, U1.33 (S3)
/S4: R2.1, U1.32 (S4)
/S5_LKON: R1.1, R11.1, U1.2 (S5_LKON)
/SCLK_H: J2.8 (SCLK_H), R12.2
/SHIELD: C3.1, C4.1, J1.SH (SHELL), R19.1
/TESTM: R7.1, U1.78 (TESTM)
/TPA2+: J1.6 (TPA+), R15.1, U1.59 (TPA2+), U2.1 (D1+), U2.10 (NC10)
/TPA2-: J1.5 (TPA-), R14.1, U1.58 (TPA2-), U2.2 (D1-), U2.9 (NC9)
/TPB2+: J1.4 (TPB+), R17.1, U1.56 (TPB2+), U2.4 (D2+), U2.7 (NC7)
/TPB2-: J1.3 (TPB-), R16.1, U1.55 (TPB2-), U2.5 (D2-), U2.6 (NC6)
/TPBIAS2: C2.1, R14.2, R15.2, U1.60 (TPBIAS2)
/TPB_CM: C1.1, R16.2, R17.2, R18.1
/XI: C6.1, U1.27 (XI), Y1.3 (X2)
/XO: C7.1, U1.26 (XO), Y1.1 (X1)

Notes on the sheet:
Strap mode 3 (S5=0 S4=1 S3=0): ports 2 and 1 data-strobe only, port 0 bilingual and unused. Cable power (VP) is not connected.

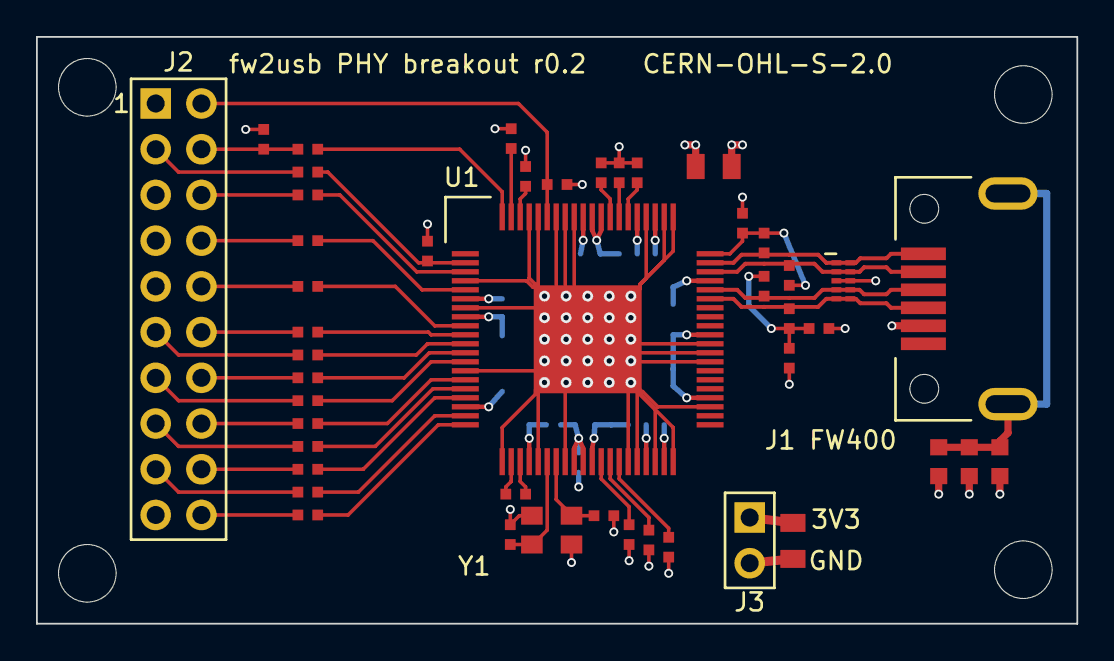
[picture p4: board phy-breakout.kicad_pcb from above]

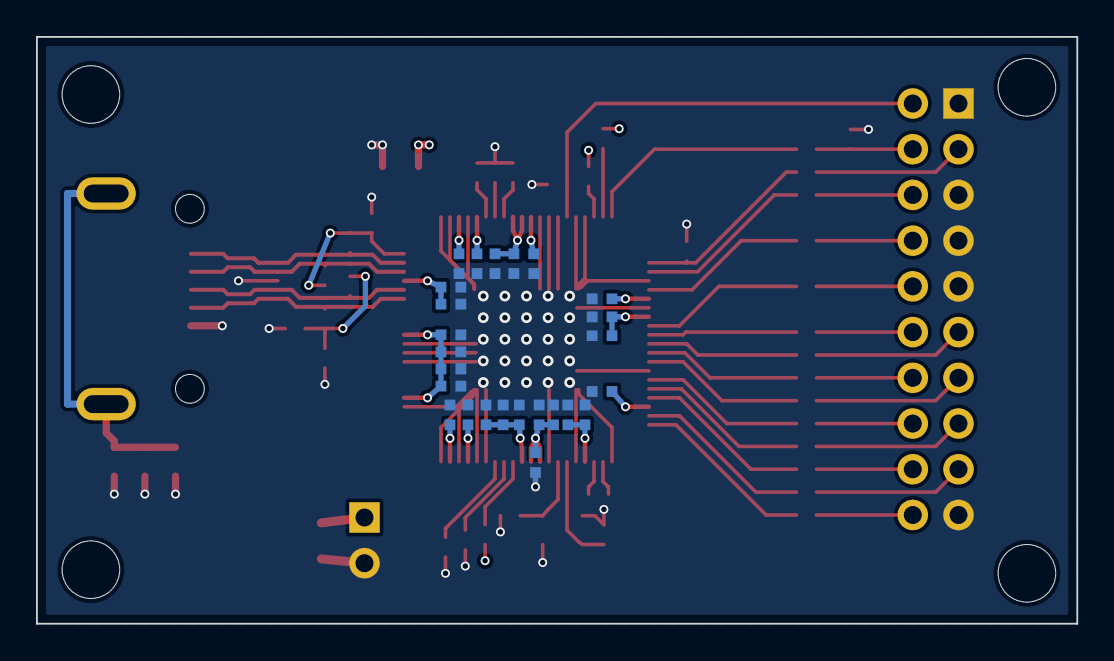
[picture p5: board phy-breakout.kicad_pcb from below]

Board: 4 copper layers, 57.8 x 32.6 mm, 75 parts (25 on the bottom side), 52 nets.

Other parts of the board:
H1, H2, H3, H4: M3; MH3
