Efllux/fw2usb/(commit log)

2026-11-09 Start soft-PHY research track: fw-phy-model crate and design note
2026-11-09 Research cable PHY arbitration and model two-node initialization with generic speed budgets
2026-11-09 Document and simulate experimental S100 analog front end
    [ds-results.csv]
2026-11-09 Define three-tier USB architecture and draft wire contracts
2026-11-09 Catalog FireWire audio families and pinned implementation evidence
    [models.csv]
2026-11-09 Match eye plot caption to simulated terminal capacitance
2026-11-09 Add source-traced LREQ and status PHY simulation primitives
2026-11-09 Add streaming PHY transmit RTL and independent pin simulation
2026-11-09 Exercise asynchronous FIFO with drifting jittered clocks
2026-11-09 Integrate software reset and LinkOn with PHY power state
2026-11-09 Propagate detected PHY interrupts to status transfers
2026-11-09 Add link CRC self ID topology and cycle timer foundations
2026-11-09 Validate wire packets and generate CRC padded packets and cycle starts
2026-11-10 Use fixed array chunks for current Rust CI lint
    [lib.rs]
2026-11-10 Attach native raw command worker and coordinate USB session resets
    [client.rs, main.rs]
2026-11-10 Draft sourced legacy PHY breakout schematic and placed PCB
    [BOM.csv, phy-breakout.kicad_pcb, phy-breakout.kicad_sch]
2026-11-10 Exclude transient KiCad project state
2026-11-10 Arm capture on the first credit grant
2026-11-12 hardware: record PHY choice, datasheet comparison and schematic review
    Working notes for the PHY breakout: why the board targets TSB41BA3F-EP,
    what differs from the TSB41AB2 the gateware was written against, and the
    schematic corrections with SLLSFA1 page and table citations. The scripts,
    schematic and PCB are updated in later commits.
2026-11-13 hardware: apply schematic corrections and route the PHY breakout
    Generator scripts now produce a placed and fully routed 4-layer board:
    strap mode 3, series resistors on the whole PHY-LINK bus, LPS pull-down,
    ESD array on the cable pairs, a real FW400 connector footprint (Keystone
    927TR land pattern), decoupling on the back under the pin rows, thermal
    via field, ground and 3.3 V planes.
    KiCad 8.0.9: ERC 0, DRC 0 violations, 0 unconnected. Schematic parity
    still reports the ten deliberately unconnected pads; fabrication outputs
    and README are not updated yet.
    [BOM.csv, phy-breakout.kicad_pcb, phy-breakout.kicad_sch]
2026-11-13 hardware: clean schematic parity, add fabrication outputs for the PHY breakout
    Unconnected pins now carry the single-pad nets KiCad derives from the
    schematic, so the parity check passes. Silkscreen follows the board-house
    minimums. build.sh regenerates everything and writes Gerbers, drill files,
    pick-and-place, BOM and assembly drawings into fab/.
    KiCad 8.0.9: ERC 0; DRC 0 violations, 0 unconnected, 0 parity issues.
    [BOM.csv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]
2026-11-13 hardware: document the PHY breakout revision 0.2
    README now describes the finished board: circuit summary, new J2 pin
    table, layer use, board-house rules, checks before ordering, assembly
    notes, cost estimate and the measurements still needed on real hardware.
    REVIEW.md and the hardware index are brought up to date.
